MidnightOnMars/clawd-pico-case/stl/aw1/README.md

# Atomic Wedgie base v1 (RP2040-Plus with a battery)

**Old test. Don't print. For an Atomic Wedgie use [`stl/atomic-wedgie/`](../atomic-wedgie/README.md).**

`base-floor-down.stl`, red PETG. Battery plug slot, BOOT pin hole, and a hole
for a RESET button: print one more `stl/current/button.stl` in red and drop it
in from inside before the board. Lid, joystick and buttons from `stl/current/`.
