MidnightOnMars/clawd-pico-case/stl/aw2/README.md

# Atomic Wedgie base v2 (RP2040-Plus with a battery)

**Old test. Don't print. For an Atomic Wedgie use [`stl/atomic-wedgie/`](../atomic-wedgie/README.md).**

Same files as `stl/atomic-wedgie/` (red base, black RESET plunger). The
plunger is not a front button; "buttons" means `stl/current/button.stl`.
