MidnightOnMars/clawd-pico-case/stl/resin-v1/full-set.stl

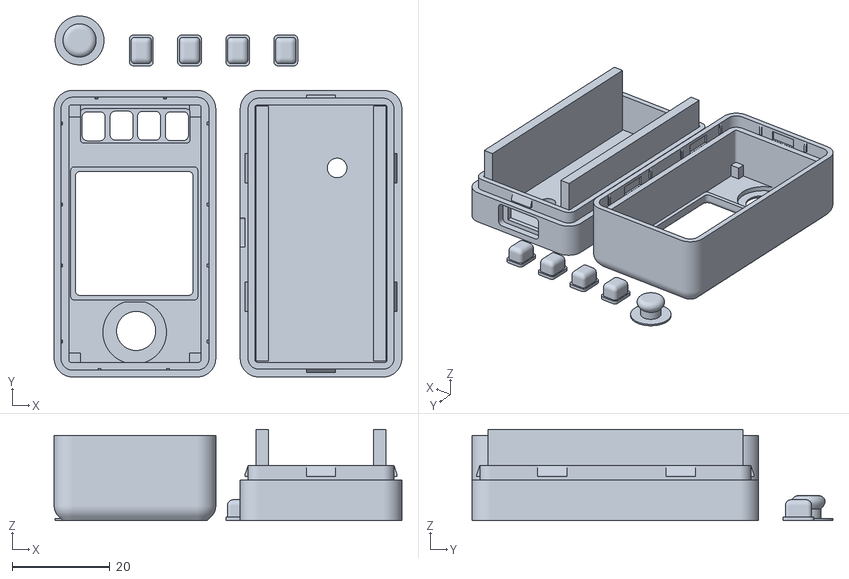
[picture p1: CAD file, 2026-10-23]
stl/resin-v1/full-set.stl
71.1 x 73.8 x 18.7
