MidnightOnMars/clawd-pico-case/stl/atomic-wedgie/aw-reset-plunger.stl

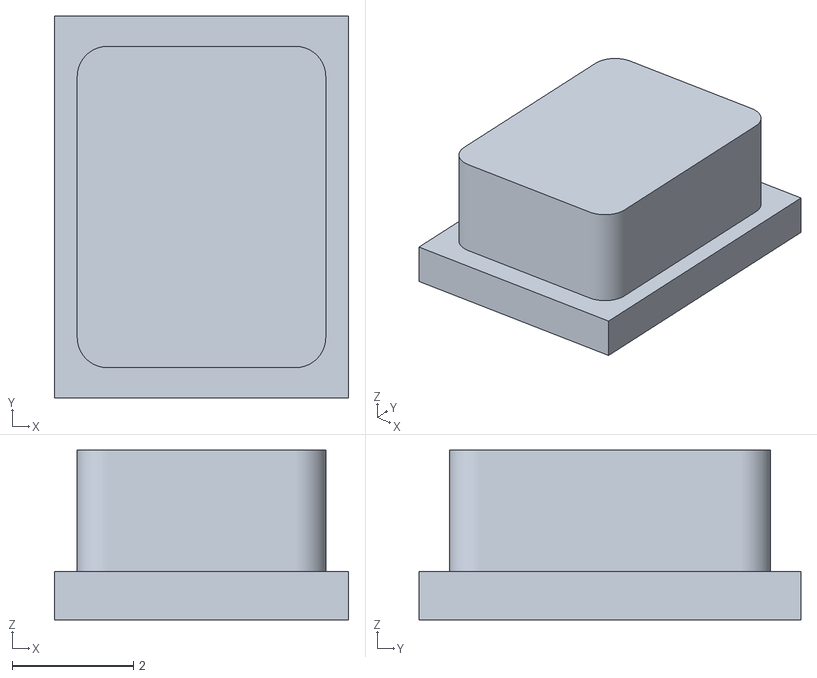
[picture p2: CAD file, 2026-10-13]
stl/atomic-wedgie/aw-reset-plunger.stl
4.85 x 6.30 x 2.80
