MidnightOnMars/clawd-pico-case/stl/resin-v1/joystick-j24-a.stl

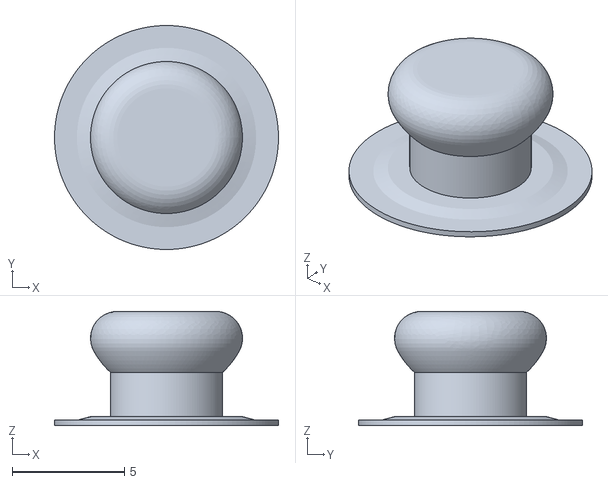
[picture p3: CAD file, 2026-11-12]
stl/resin-v1/joystick-j24-a.stl
10.0 x 10.00 x 5.10
