MidnightOnMars/clawd-pico-case/stl/resin-v1/button.stl

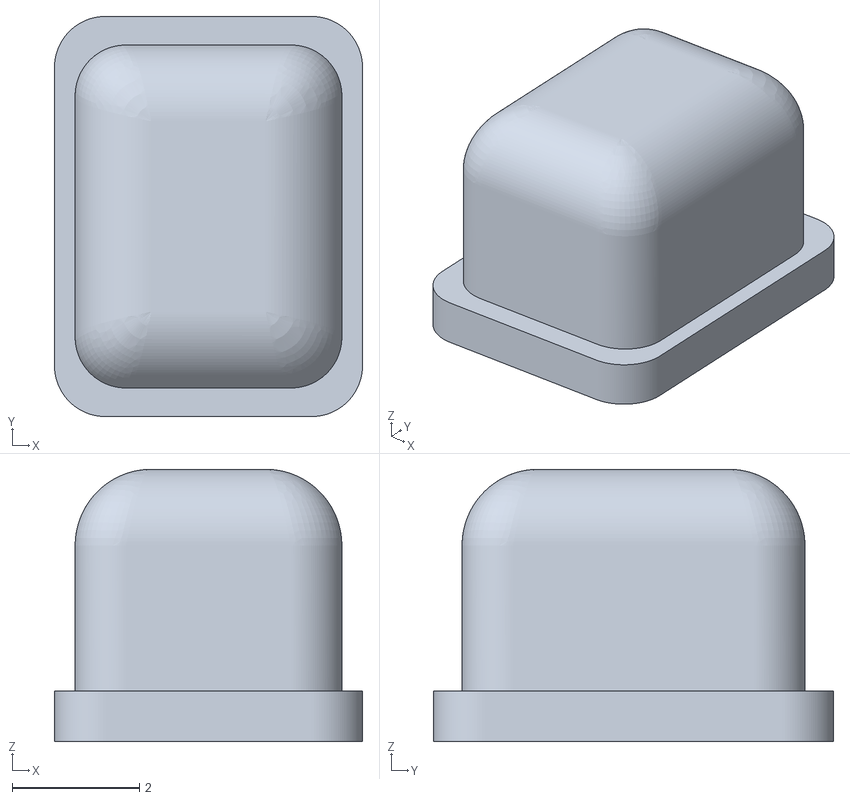
[picture p4: CAD file, 2026-10-23]
stl/resin-v1/button.stl
4.85 x 6.30 x 4.29
