MidnightOnMars/clawd-pico-case/stl/resin-v1/lid.stl

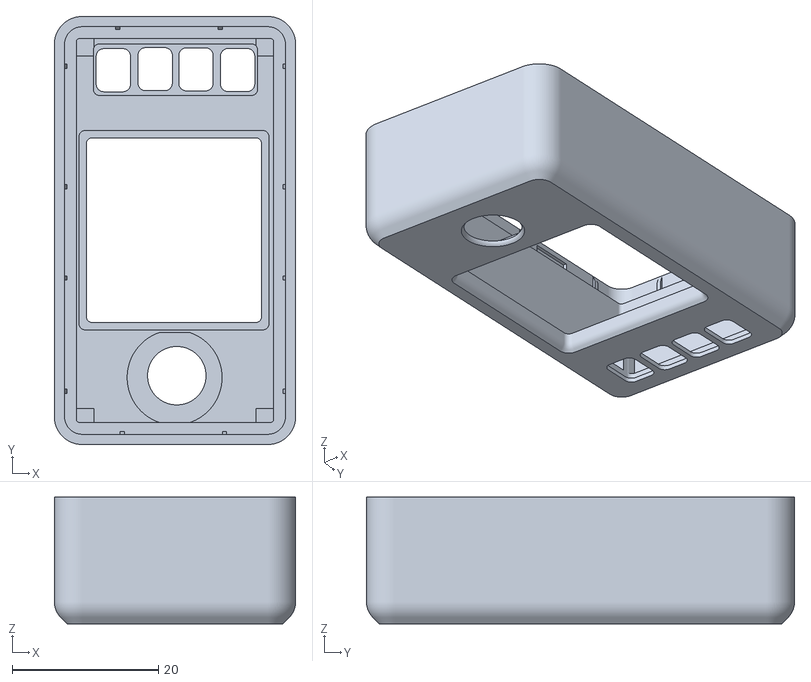
[picture p5: CAD file, 2026-10-23]
stl/resin-v1/lid.stl
33.0 x 58.6 x 17.4
