MidnightOnMars/clawd-pico-case/stl/resin-v1/base.stl

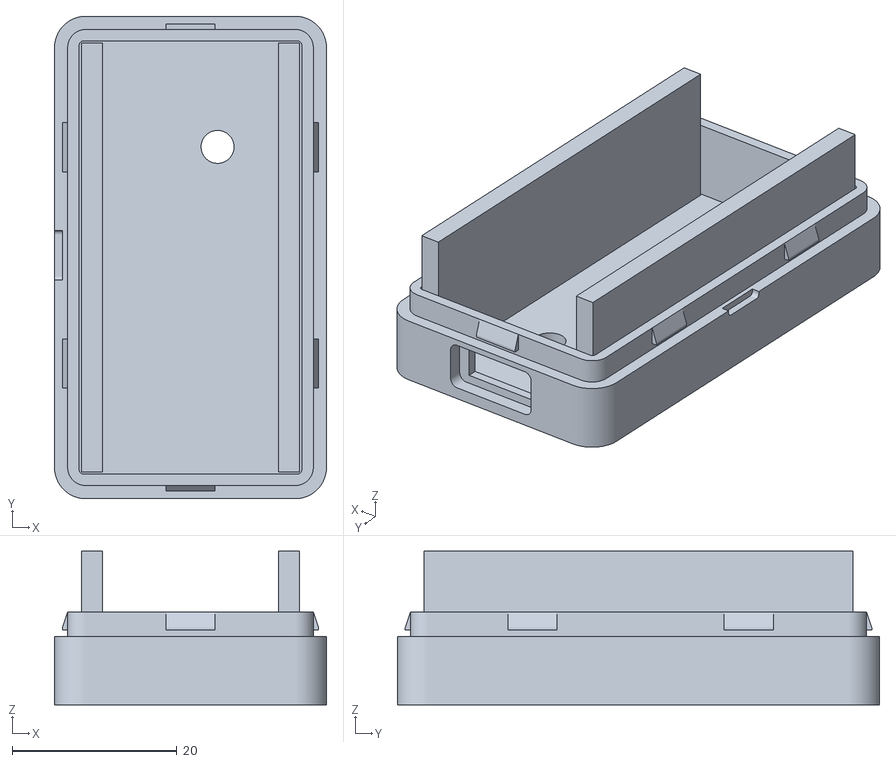
[picture p6: CAD file, 2026-10-23]
stl/resin-v1/base.stl
33.0 x 58.6 x 18.7
