MidnightOnMars/clawd-pico-case/(list of files, cad)

Other CAD files:
stl/resin-v1/joystick.stl
