MidnightOnMars/clawd-pico-case/prints/2026-11-12-resin-v1-first-article.md

# resin-v1 first article (planned, not printed yet)

First print of the resin variant, on a Formlabs Form Studio 1. It is a fit test:
nothing in `stl/resin-v1/` has been printed before. Print sheet and first-fit steps:
[`stl/resin-v1/README.md`](../stl/resin-v1/README.md).

| Print | Resin | File | SHA256 | Copies |
|---|---|---|---|---|
| 1 | Alpha Clear Resin | `stl/resin-v1/lid.stl` | `320b1b5c...` | 2 |
| 1 | Alpha Clear Resin | `stl/resin-v1/base.stl` | `6340c52a...` | 2 |
| 2 | Tough 2000 Resin V2 | `stl/resin-v1/joystick-j24-a.stl` (J24-A) | `2bc4d60b...` | 3: 100 %, 98.5 %, 97 % |
| 2 | Tough 2000 Resin V2 | `stl/resin-v1/joystick.stl` (J24-B) | `b9aef37b...` | 3: 100 %, 98.5 %, 97 % |
| 2 | Tough 2000 Resin V2 | `stl/resin-v1/button.stl` | `c5f2f4a3...` | 4 |
| 3 | Flexible 80A Resin V2 | `stl/resin-v1/button.stl` | `c5f2f4a3...` | 6 |

This is the print sheet's full list, the ideal. If time is tight the short list is
printed instead: one lid, one base, both joystick caps at 100 %, four rubber buttons.

Board for the fit test: a pink USB-C RP2040 Pico clone with soldered headers
([Amazon B0GQRMVT4P](https://www.amazon.com/dp/B0GQRMVT4P)). Its listing photo shows
the same layout as the PINK board in `MEASUREMENTS.md`: one button beside the USB-C
socket and the `Pico (c) 2022` silkscreen. It has not been measured against the PINK
rows.

Layer height: material default. Orientation and supports: the operator's choice,
except that the joystick caps must not sit flange down directly on the build platform
(print sheet, Print setup). Record what was used below.

## Results

Fill in after the fit test. A planned test is not evidence of a successful print.

- List printed (full or short) and any extras added:
- Date printed, printer, PreForm version:
- Orientation and supports used for each part:
- Post-cure used for the clear parts:
- Empty lid on empty base, as printed: seated? clicked? how much force?
- Crush ribs: left as printed, or eased by how much:
- Catches: latched as printed, or trimmed:
- Clear skirt at the six pockets after closing and after opening:
- Opening at the pry slot:
- With the boards in: seated? pads or end walls eased?
- USB cable:
- Joystick: which cap (A or B, which scale) grips the stick; any double click or clunk:
- Buttons: rubber caps stay in? feel? rigid spares used?
- Closed case height (model 25.64 mm; Austin's PETG case measured 25.76):
- Photos:
