MidnightOnMars/clawd-pico-case/assembly/ASSEMBLY.md

# Assembly

Photos in order. Draft. This becomes a one-page guide later.

## What you need

- Screen board (Waveshare Pico-LCD-1.3)
- Pico (the red USB-C RP2040 board)
- Trust M chip board
- 4-wire cable (white, yellow, black, red) with a small plug: [the ones we use (Amazon)](https://www.amazon.com/dp/B0F6TYG426)
- Case: white lid, black base, joystick cap, 4 buttons (1 green, 2 gray, 1 red)
- Wire cutters and strippers, electrical tape, a stiff breadboard jumper wire, tweezers
- A computer with Chrome, and a USB-C cable

## 1. Cable and tools

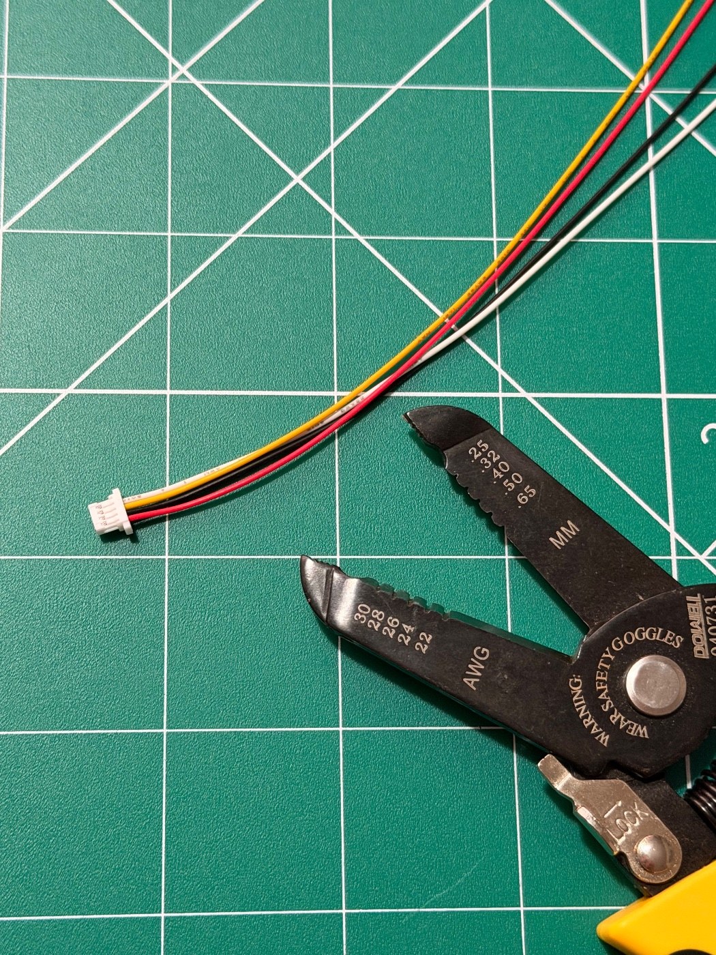
[picture p7: assembly/photos/01-cable-and-strippers.jpg]
Cable and strippers


Cable and strippers

## 2. Cut and strip the wires

Keep one plug. Cut the wires about 2 in (5 cm) from it. Strip off as much as a header socket is deep, about 5 mm (between 1/8 and 1/4 in), so the bare wire goes all the way down.

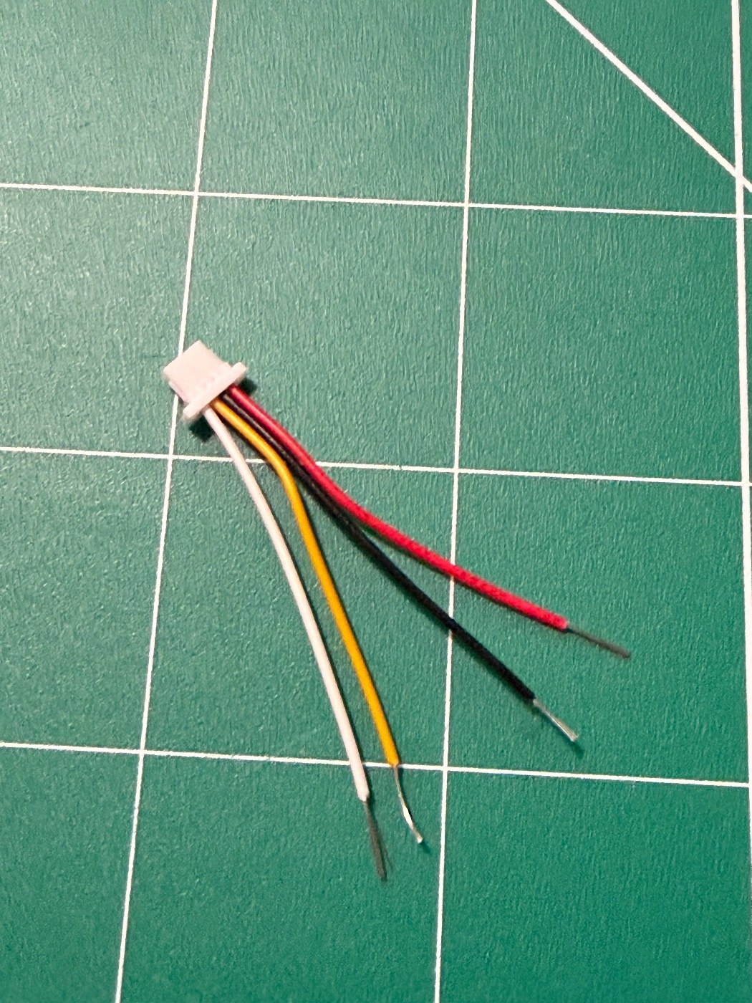
[picture p8: assembly/photos/03-cut-and-stripped-a.jpg]
Cut and stripped

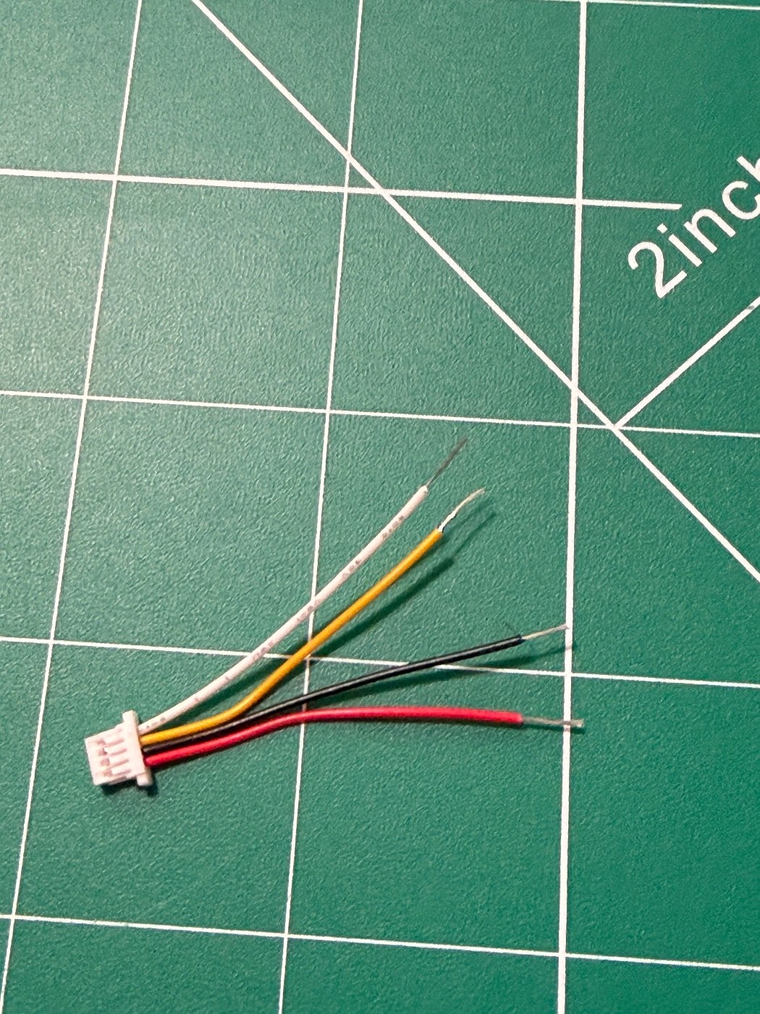
[picture p9: assembly/photos/03-cut-and-stripped-b.jpg]
Cut and stripped, other view


## 3. Lay out the screen board and the wiring guide

Take out the screen board. Turn it face down, sockets up, USB mark at the top.

Each wire pushes into a socket. No solder. Count sockets from the USB end.

| Wire | Signal | Socket |
|---|---|---|
| White | GND | 3rd on the USB-side row (pin 38) |
| Yellow | 3.3 V | 5th on that row (pin 36) |
| Black | SDA | 6th on the other row (pin 6, GP4) |
| Red | SCL | 7th on the other row (pin 7, GP5) |

<!-- TODO: redraw the wiring guide as a clean diagram for the one-pager -->

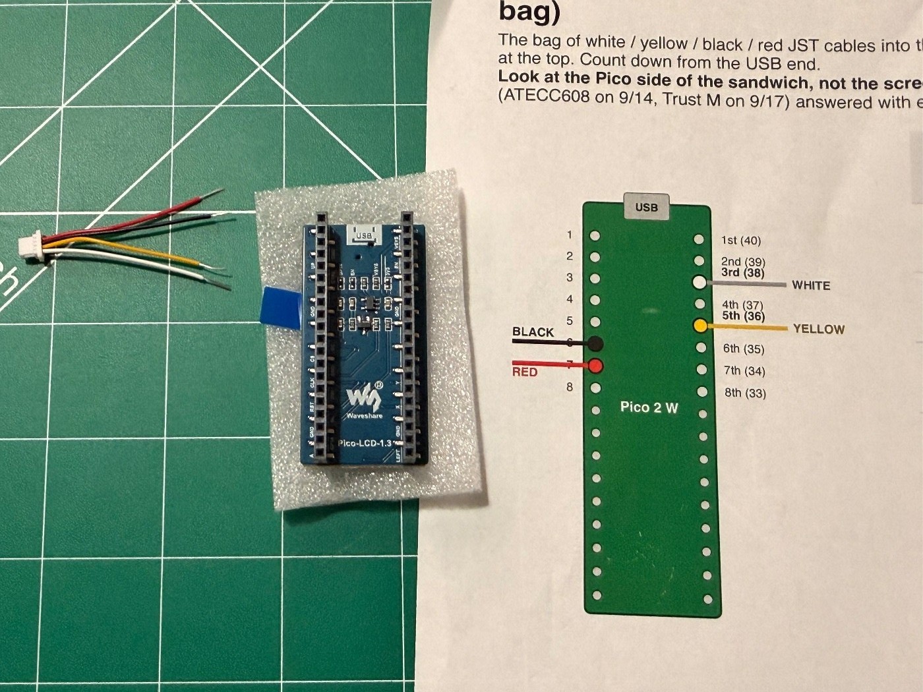
[picture p10: assembly/photos/04-board-and-guide.jpg]
Board face down with wiring guide


## 4. Push in white and yellow

Twist the strands at each wire tip tight, so each tip acts like one solid wire.

Push white into socket 3 (GND) and yellow into socket 5 (3V3) on the USB-side row. Do both together.

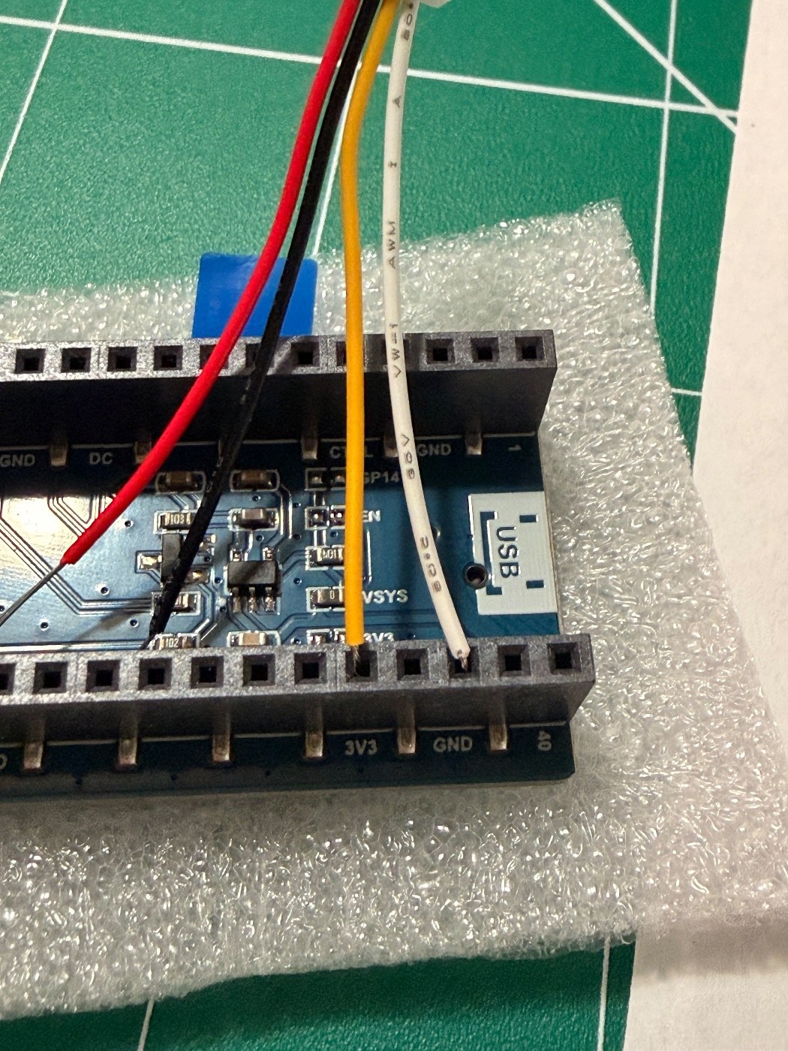
[picture p11: assembly/photos/05-white-yellow-in-header.jpg]
White and yellow in the header


## 5. Tape over the wires

Put a small piece of electrical tape over the sockets, right on top of the wires, to hold them in.

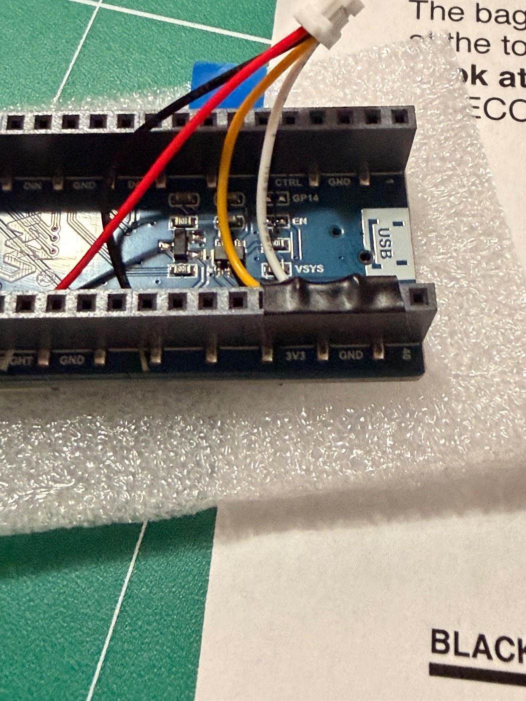
[picture p12: assembly/photos/06-tape-over-wires.jpg]
Tape over white and yellow


## 6. Poke the holes open

Push a stiff breadboard jumper wire through the tape into each covered socket. This opens the holes so the Pico pins fit later. The tape still holds the wires.

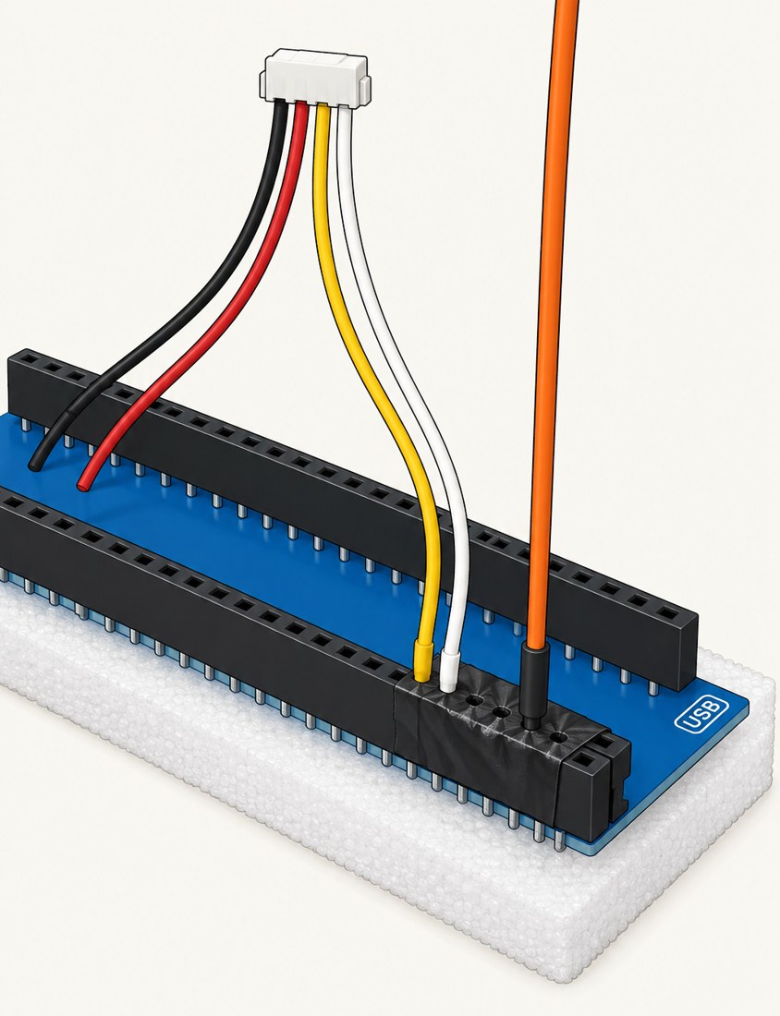
[picture p13: assembly/photos/07-poke-holes-drawing.jpg]
Poke the holes through the tape (drawing)

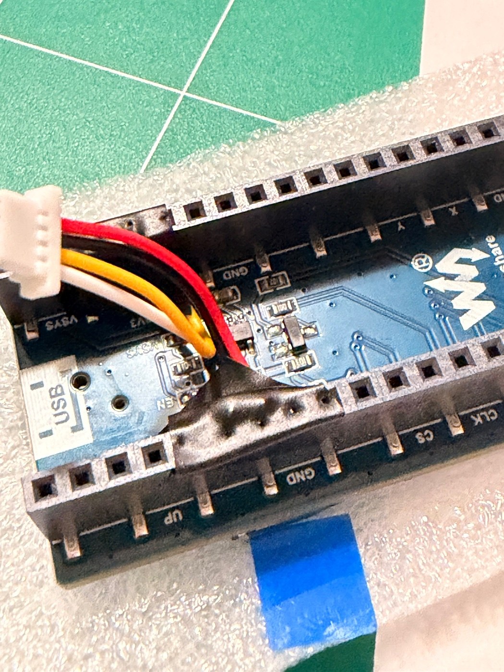
[picture p14: assembly/photos/08-black-red-taped.jpg]
Holes poked through the tape

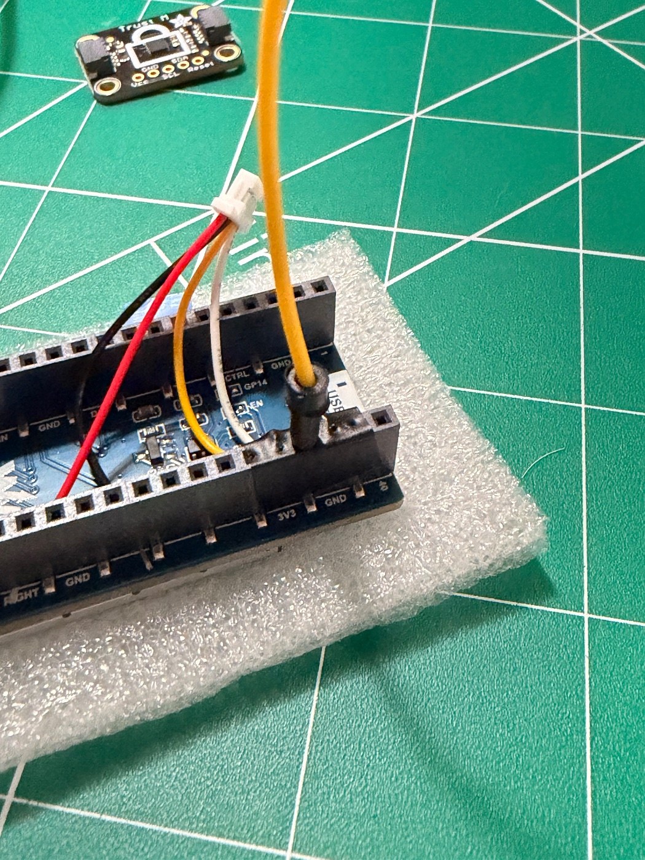
[picture p15: assembly/photos/07-poke-holes-through-tape.jpg]
Poking holes through the tape


## 7. Same on the other row: black and red

Push black into socket 6 and red into socket 7. Tape over them. Poke the holes open with the jumper wire.

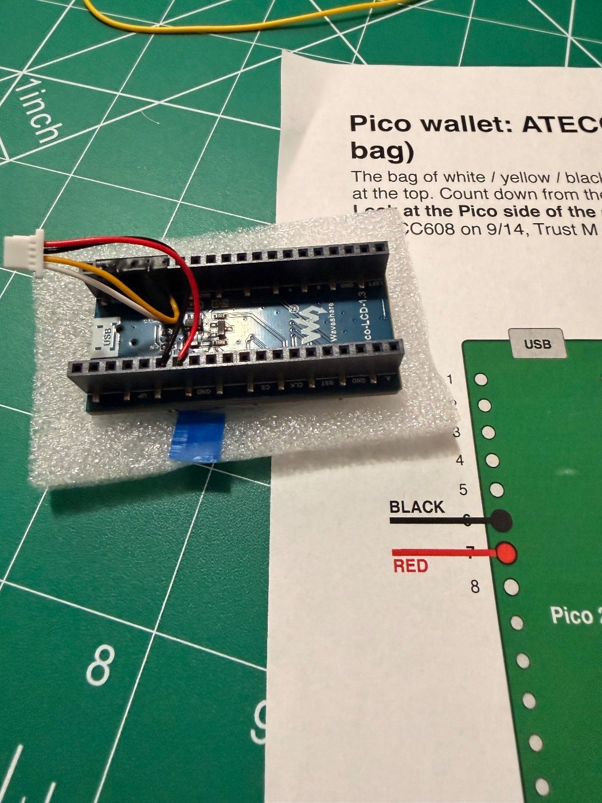
[picture p16: assembly/photos/08-black-red-guide.jpg]
Black and red, with guide

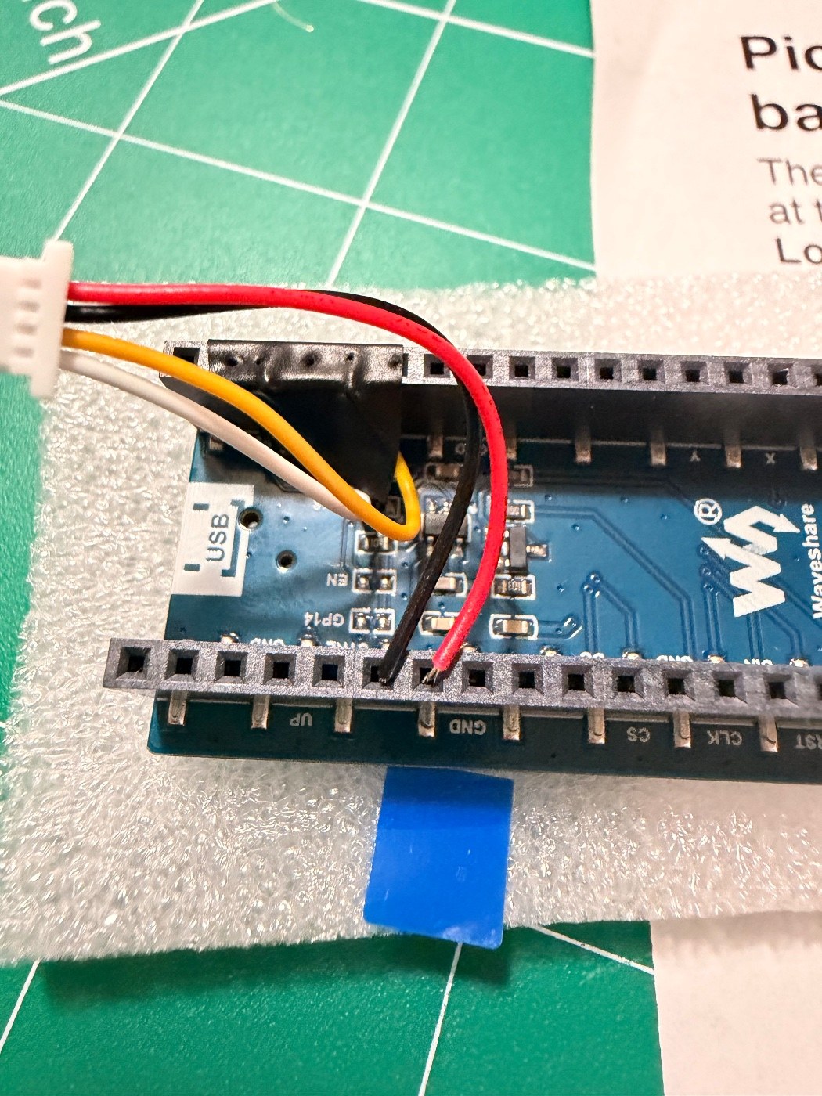
[picture p17: assembly/photos/08-black-red-in-header.jpg]
Black and red in the header

Black and red taped

## 8. Header ready

All 4 wires in, taped, holes open. Ready for the Pico.

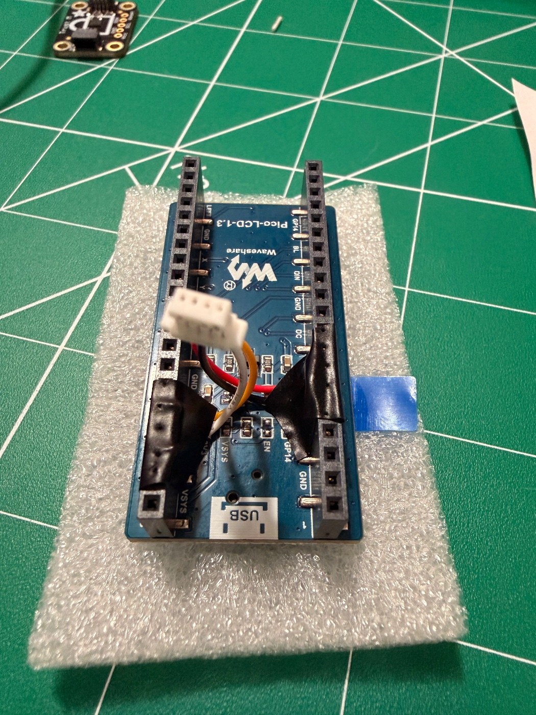
[picture p18: assembly/photos/09-header-ready.jpg]
Header ready for the Pico


## 9. How the plug fits the Trust M

Only 4 wires. Top to bottom in the photo: white, yellow, black, red.

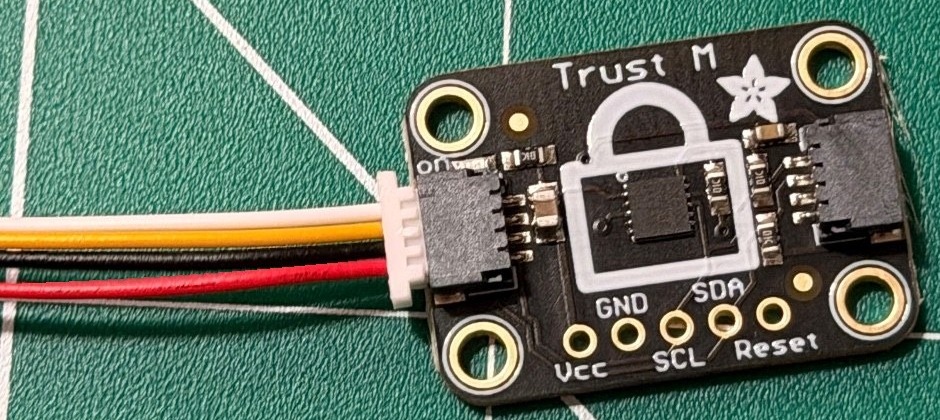
[picture p19: assembly/photos/02-trust-m-plug.jpg]
Cable plugged into Trust M


## 10. Plug in the chip

Plug the cable into the Trust M. It only fits one way.

Lay the Trust M face up on the back of the screen board, over the wires. The Pico goes on top of it next.

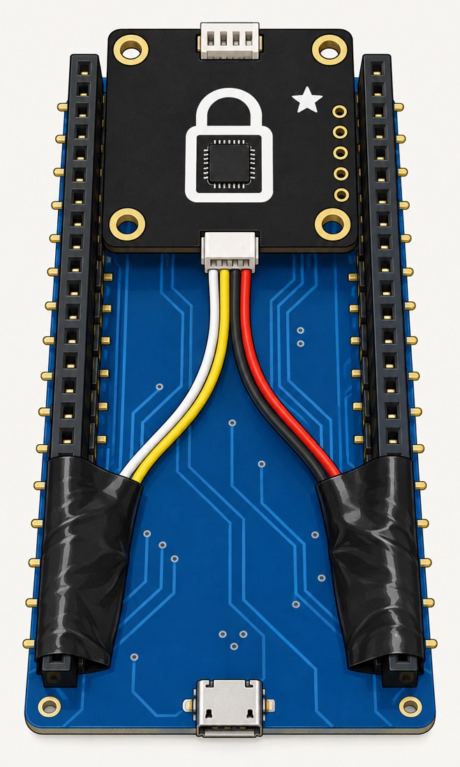
[picture p20: assembly/photos/10-chip-drawing.jpg]
Chip plugged in and laid down (drawing)

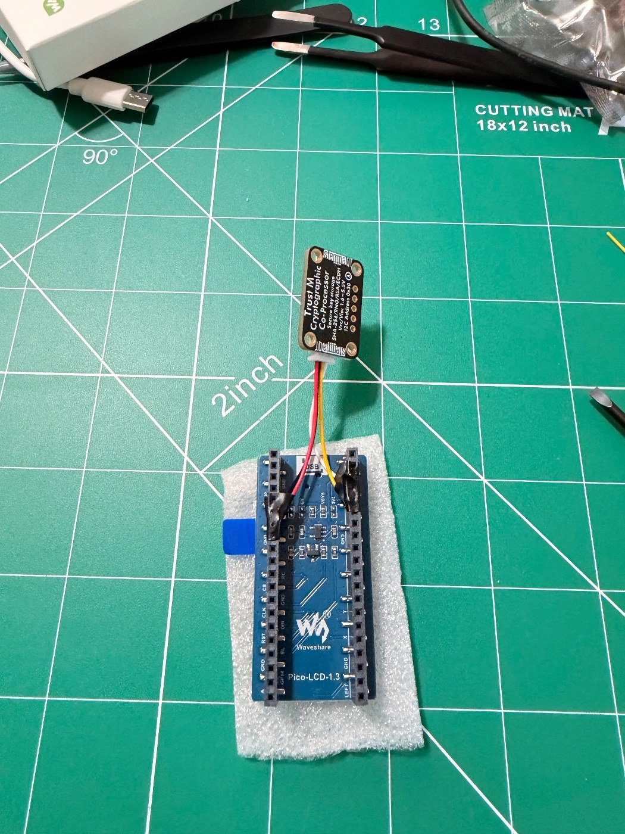
[picture p21: assembly/photos/10-chip-plugged.jpg]
Plugged in

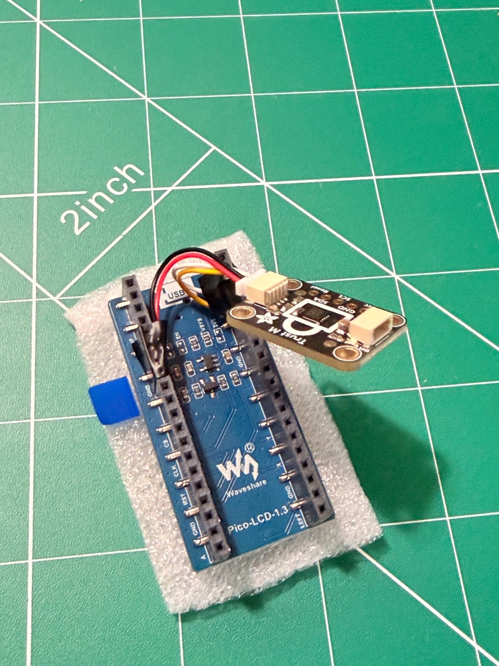
[picture p22: assembly/photos/10-chip-plugged-side.jpg]
Plugged in, from the side

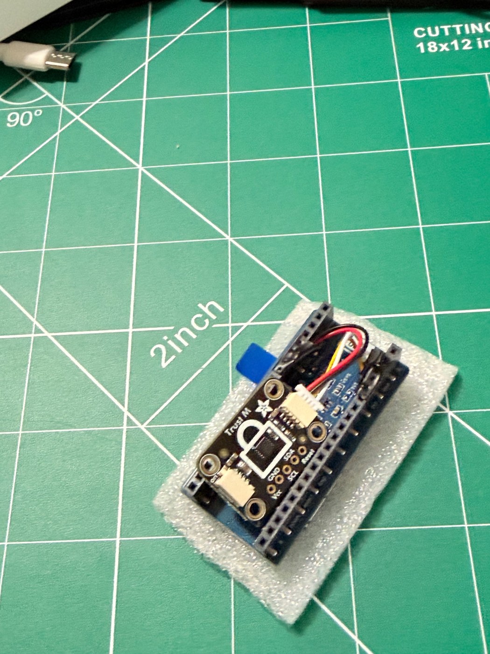
[picture p23: assembly/photos/10-chip-laid-down.jpg]
Laid down on the board

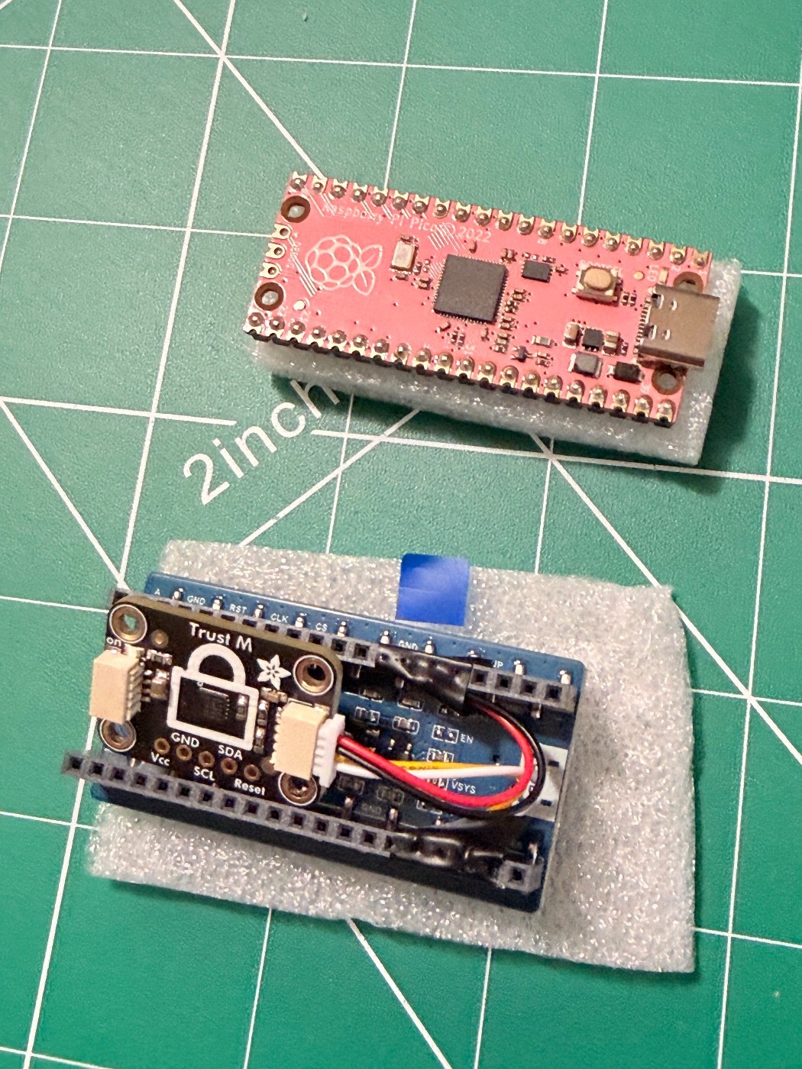
[picture p24: assembly/photos/10-ready-for-pico.jpg]
Ready for the Pico


## 11. Snap off extra board

Some Picos have a little extra board left on the end, away from the USB-C. Pinch it with pliers and snap it off. Otherwise it won't fit the case.

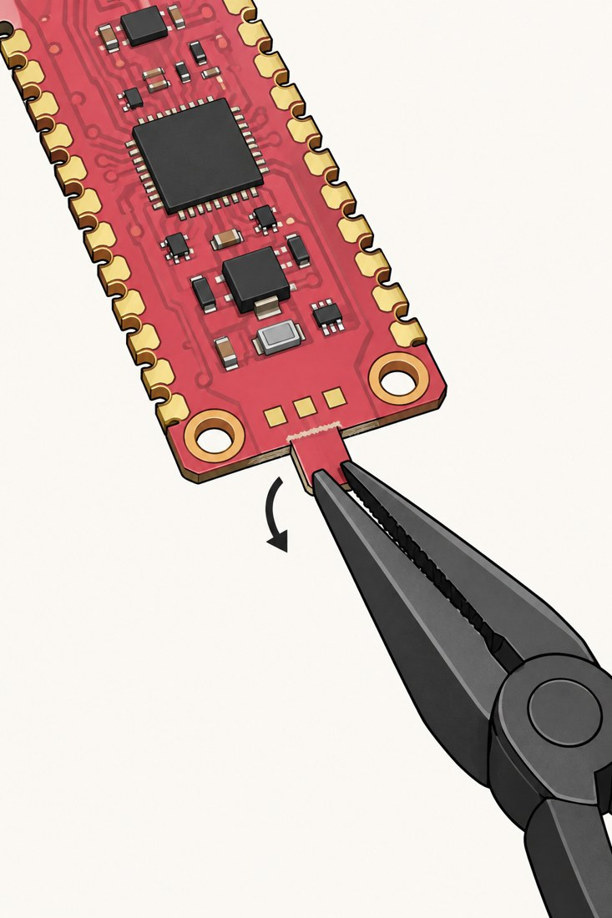
[picture p25: assembly/photos/11-snap-off-tab-drawing.jpg]
Snap off the extra board (drawing)

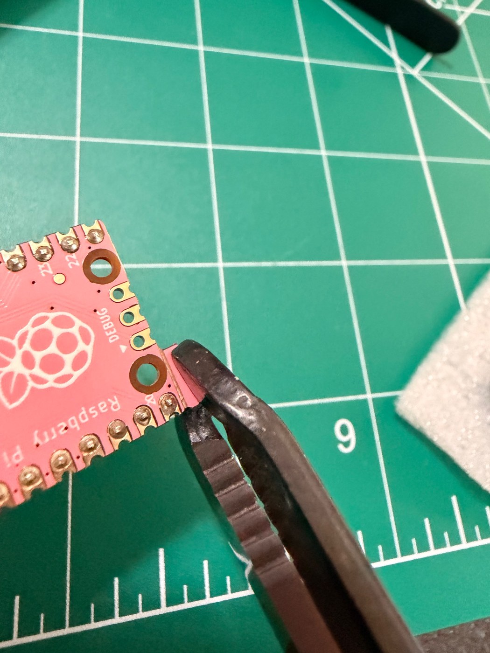
[picture p26: assembly/photos/11-snap-off-tab.jpg]
Pinch and snap

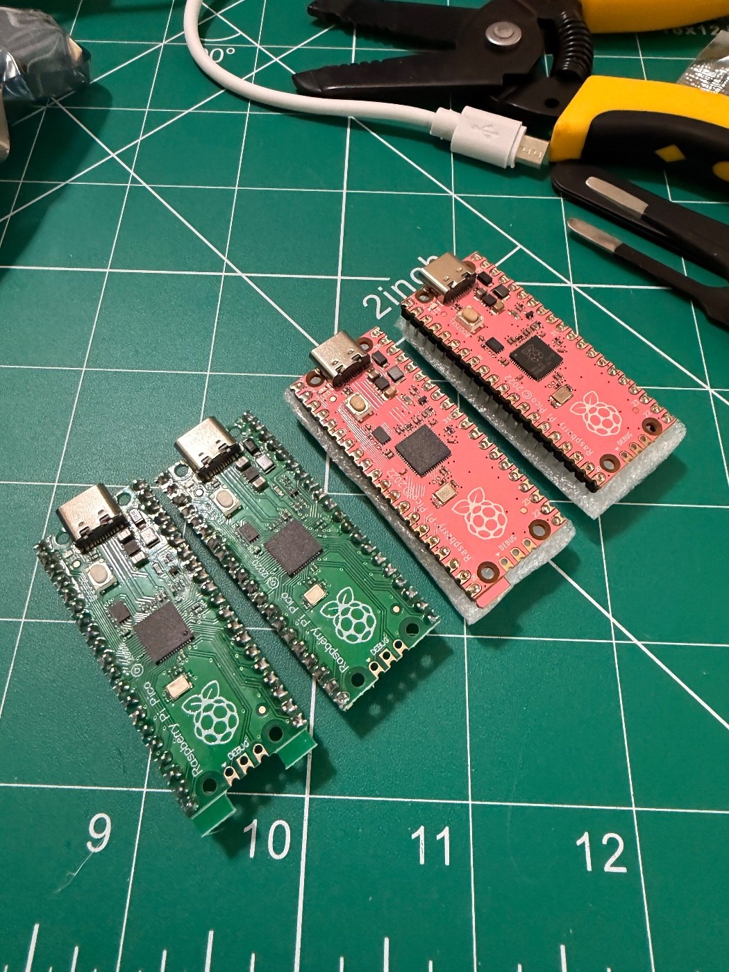
[picture p27: assembly/photos/11-picos-with-tabs.jpg]
Green Picos still have it, red ones are done


## 12. Stack the boards

Push the Pico into the sockets, USB-C at the same end as the screen board's USB mark. The Pico's chips and BOOTSEL button face out, away from the screen. Push straight, never at an angle. The Trust M ends up wedged between the two boards. Push the Pico all the way in so it's flush. No pins or wires sticking out, chip fully inside.

If anything sticks out, do it again. It won't fit the case.

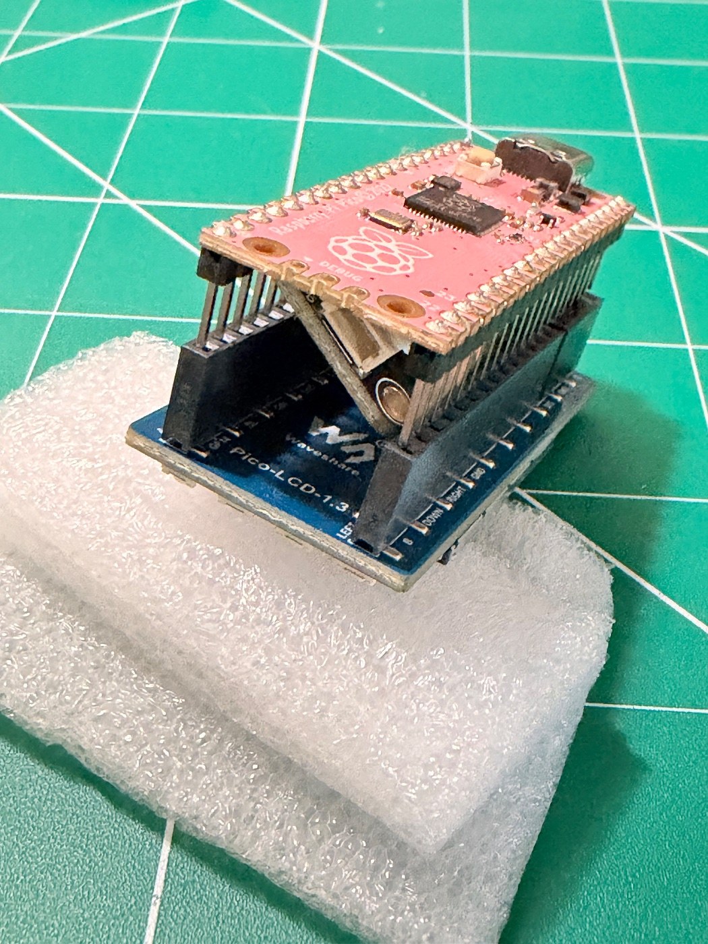
[picture p28: assembly/photos/11-pico-going-on.jpg]
Pico going on, chip wedged under it

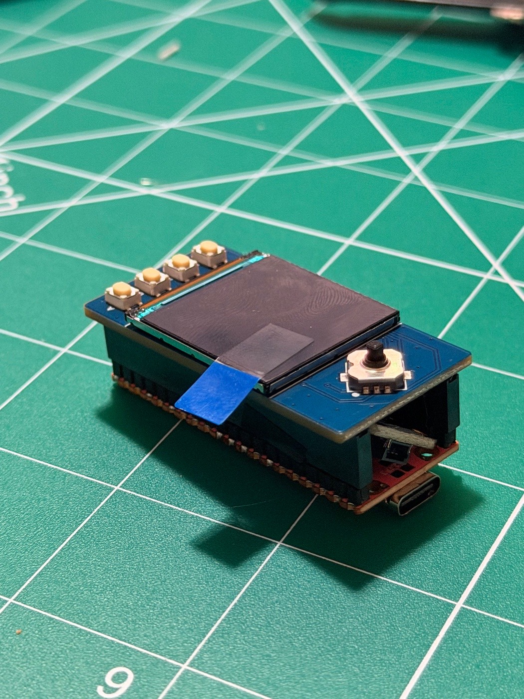
[picture p29: assembly/photos/10-stacked-top.jpg]
Stacked, from the top

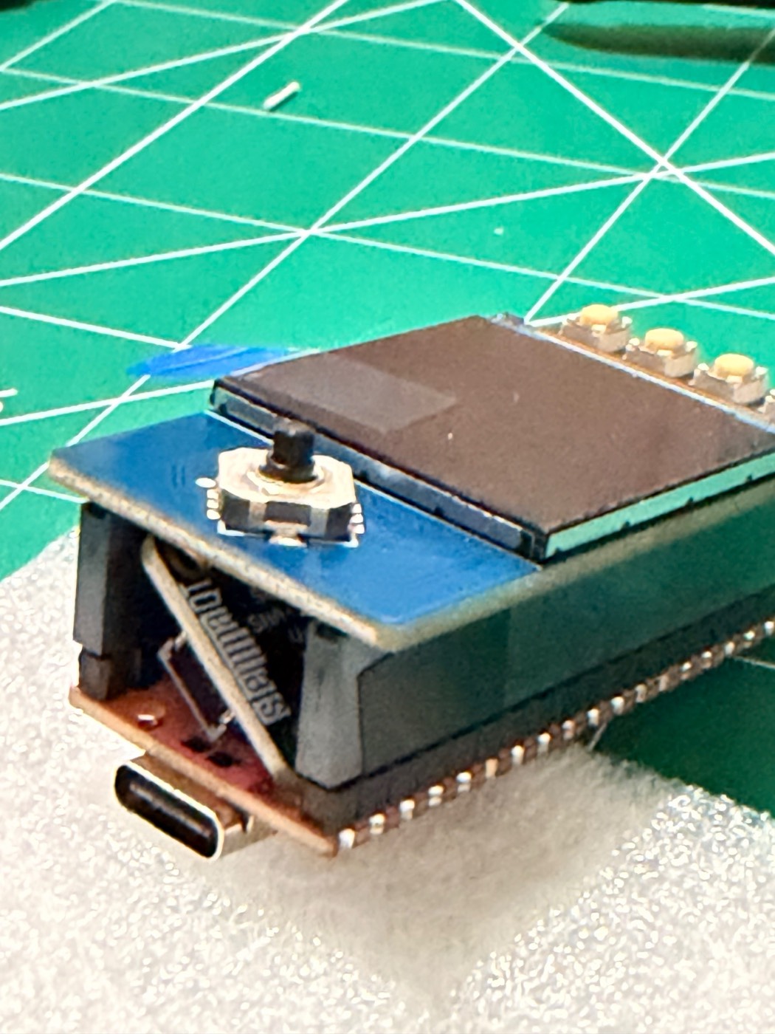
[picture p30: assembly/photos/10-chip-wedged.jpg]
Chip wedged in between

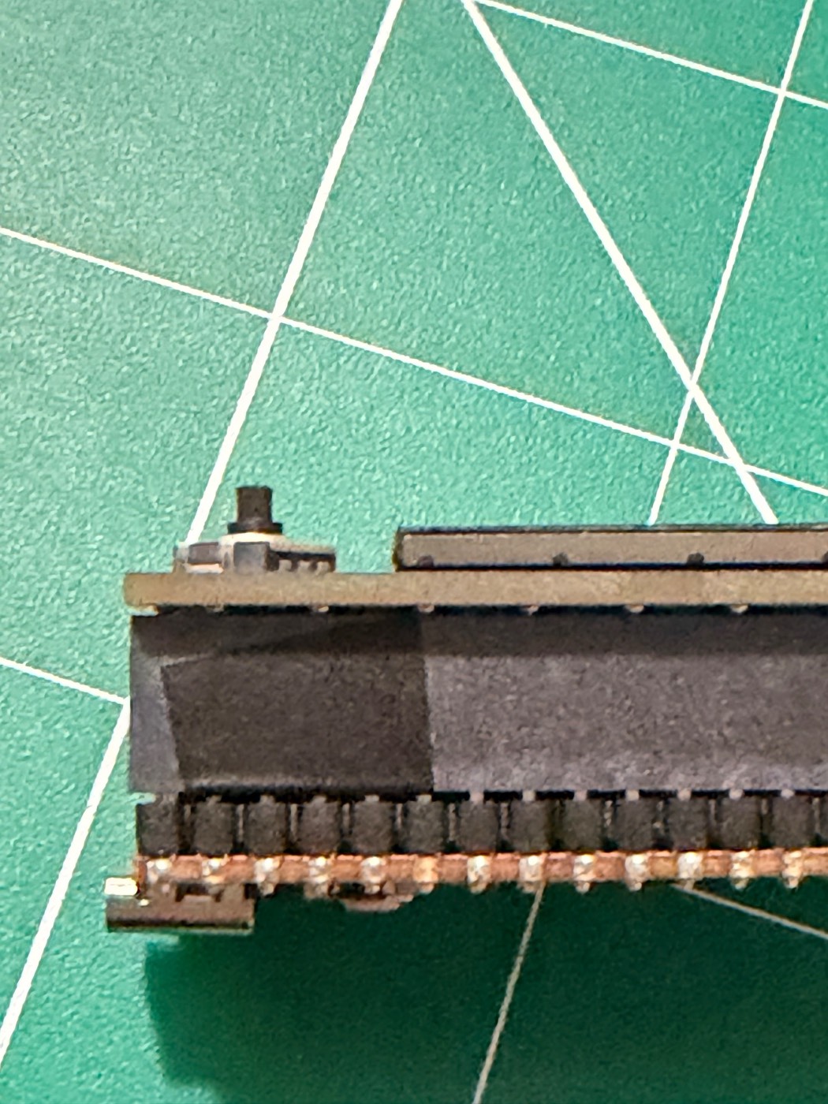
[picture p31: assembly/photos/10-headers-flush.jpg]
Headers flush

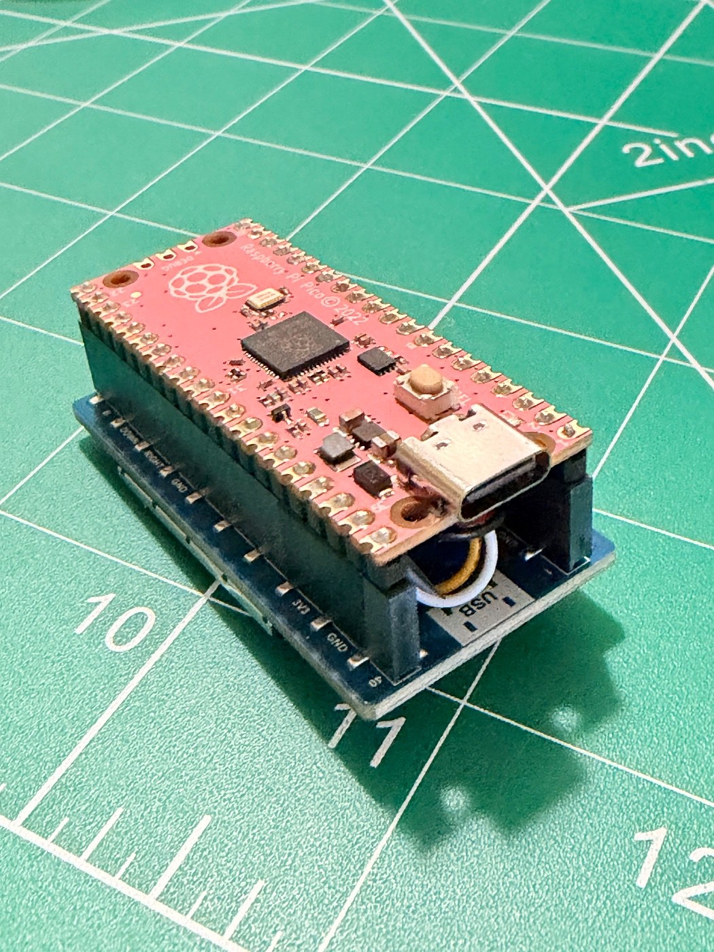
[picture p32: assembly/photos/11-stacked-usb.jpg]
Stacked, USB end


## 13. Test the boards

Hold the Pico's BOOTSEL button (tweezers help) and plug in the USB-C. Always hold it. Many Picos come with software installed and won't show up without BOOTSEL. Our pink Picos do: out of the box they flash a green light. Some come blank and work either way. Use a data cable, not a charge-only one. Go to wedgie.dev/test in Chrome and click Test it. Don't unplug while it runs.

First time on this computer? The test page has a one-time setup (a Mac profile, or one command on Linux) so Chrome stops asking about every new Pico.

Wait for the first 3 to go green: Board, Firmware, Chip. That means everything is connected. Unplug it. The other 3 (Shake, Buttons, Colors) come after the case is on.

Chip fails? A wire is in the wrong socket (step 3), a wire came out, or the Trust M touches a Pico pin. Take it apart and check.

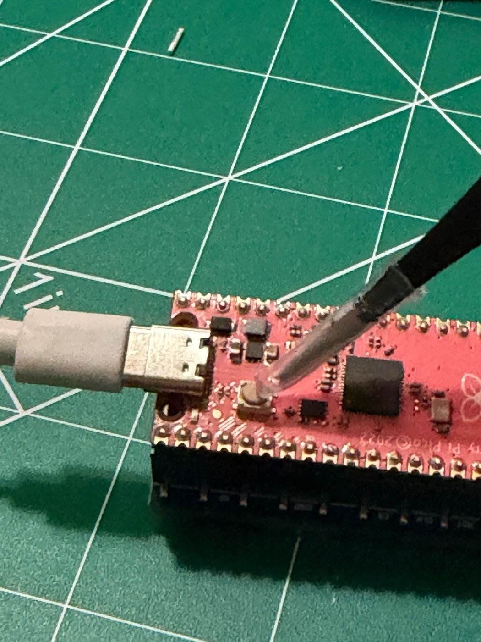
[picture p33: assembly/photos/11-bootsel.jpg]
Hold BOOTSEL, plug in

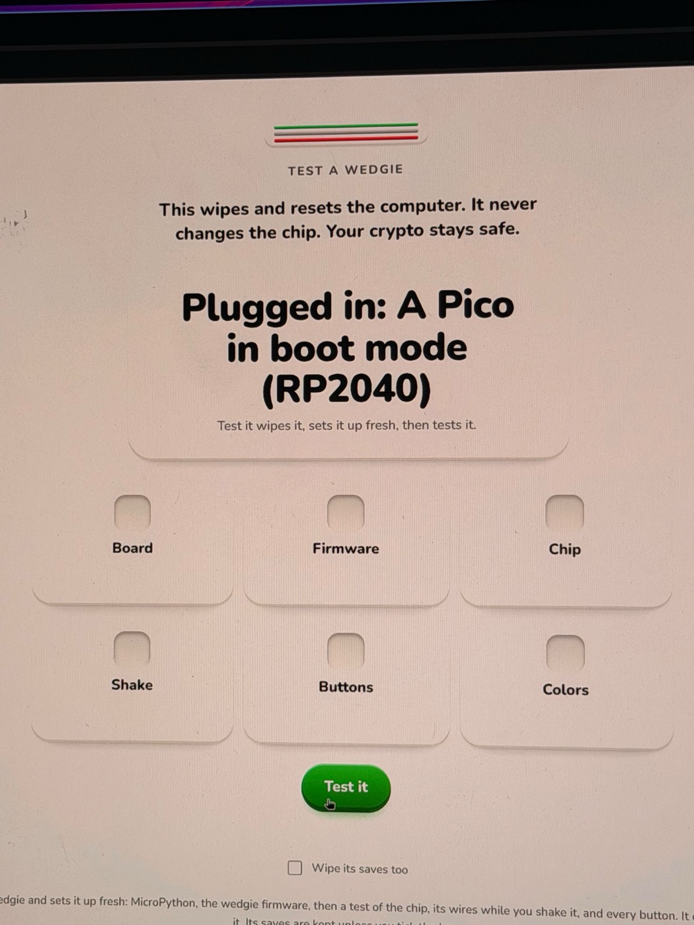
[picture p34: assembly/photos/11-test-page.jpg]
Test page

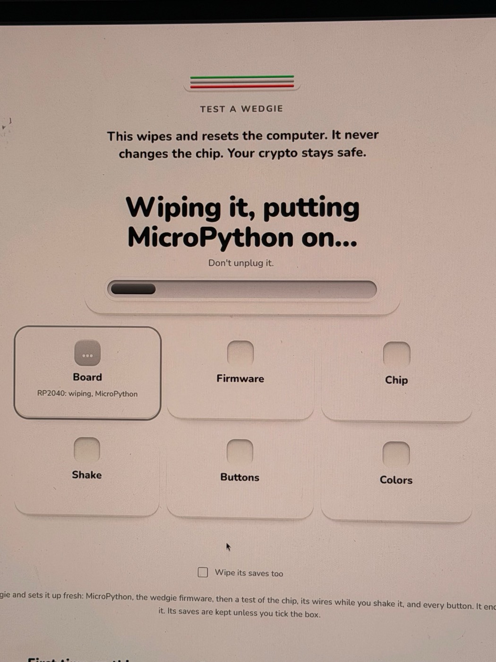
[picture p35: assembly/photos/11-test-wiping.jpg]
Wiping, putting MicroPython on

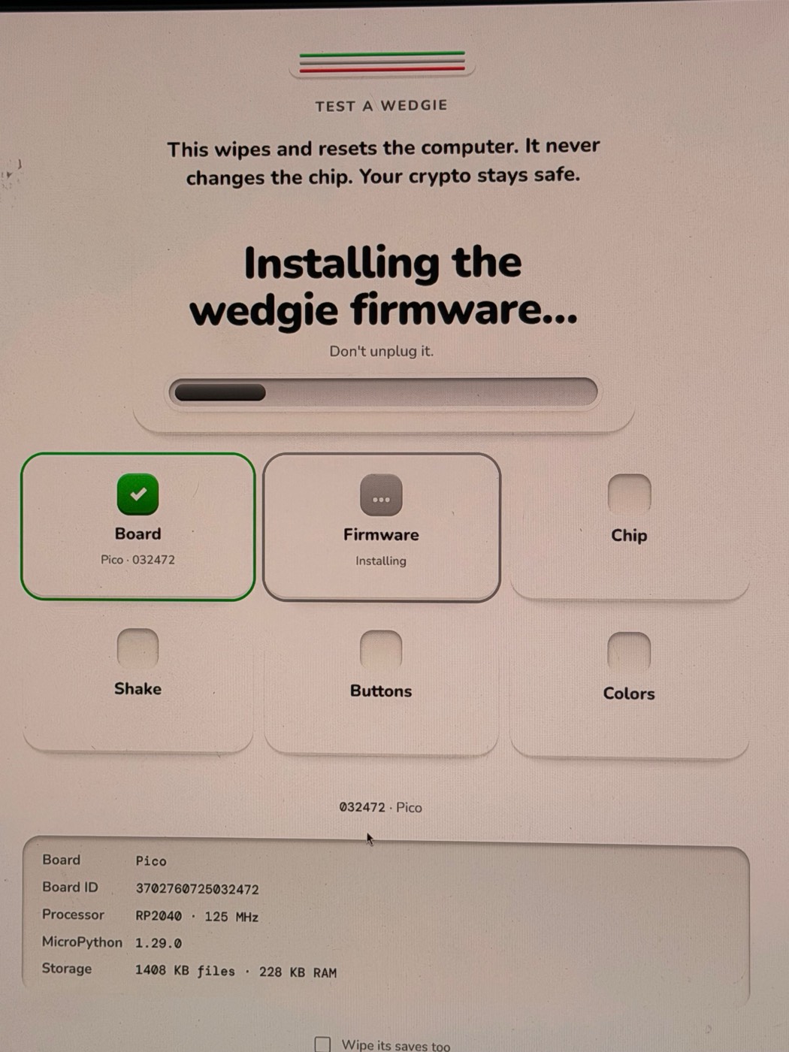
[picture p36: assembly/photos/11-test-firmware.jpg]
Installing the firmware


## 14. Pick the base

The base color says what's inside:

- Red: Pico W with a battery (the Atomic wedgie)
- Black: Trust M chip
- Gray: ATECC608 chip

This build is Trust M, so black.

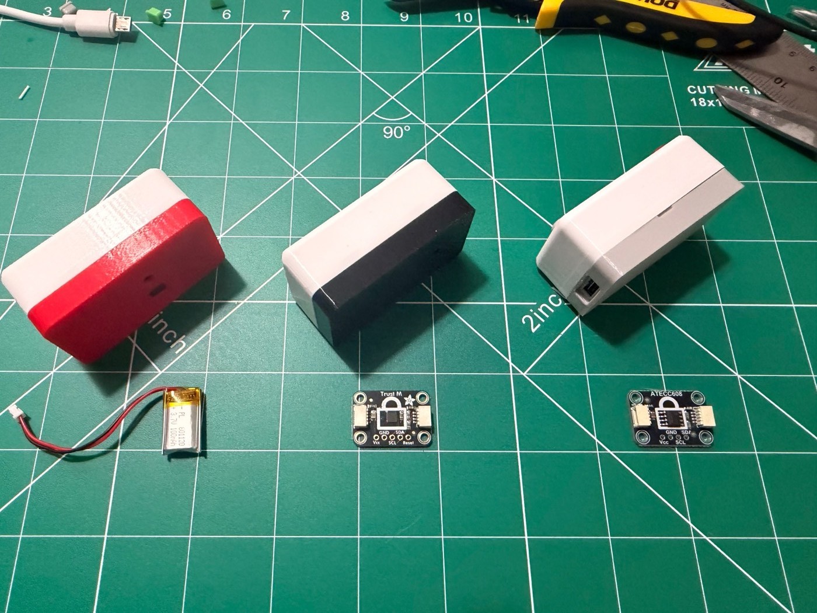
[picture p37: assembly/photos/13-bases.jpg]
The three bases


## 15. Check the USB-C fit

Set the stacked boards into the base, USB-C into the hole. The USB-C port must line up perfectly with the hole.

Not lined up? Push the Pico all the way into the screen board's sockets, and make sure the screen board sits flush on the base's supports.

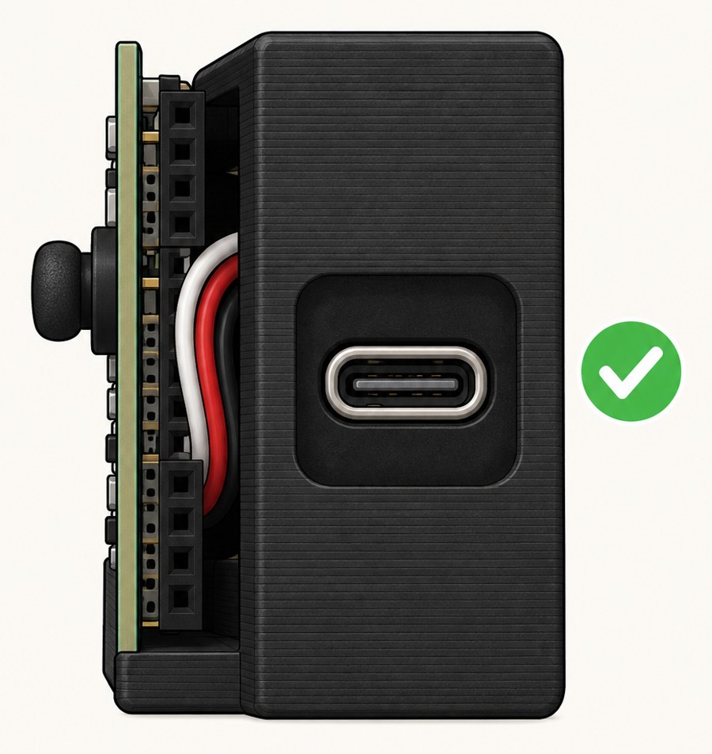
[picture p38: assembly/photos/15-usb-fit-drawing.jpg]
USB-C lined up with the hole (drawing)

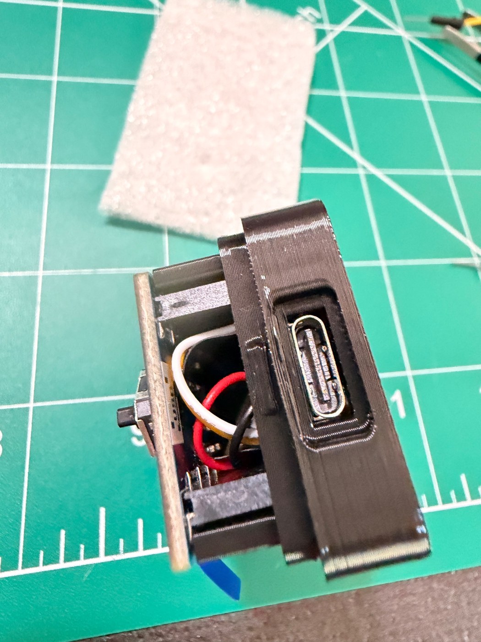
[picture p39: assembly/photos/15-usb-fit-check.jpg]
USB-C lined up with the hole


## 16. Peel the screen protector

Pull the blue tab off the screen.

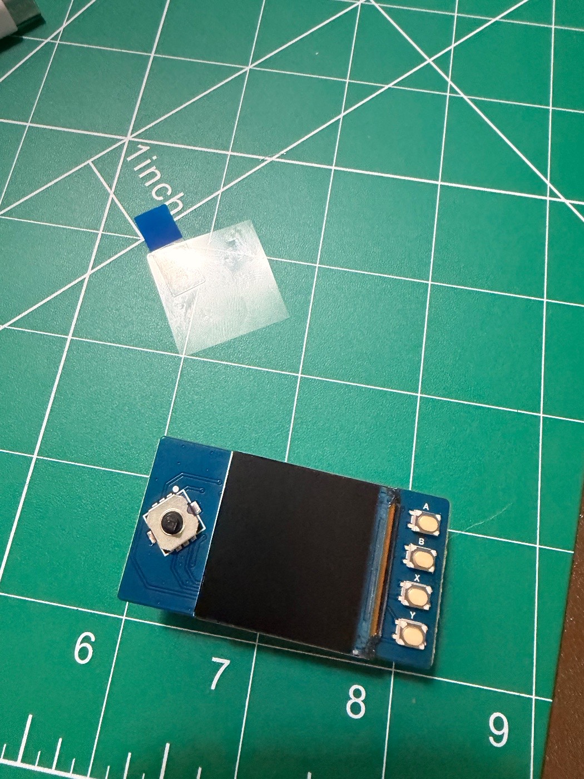
[picture p40: assembly/photos/13-screen-protector.jpg]
Screen protector off


## 17. Case parts

White lid, black base, joystick cap, 2 gray buttons, 1 green, 1 red.

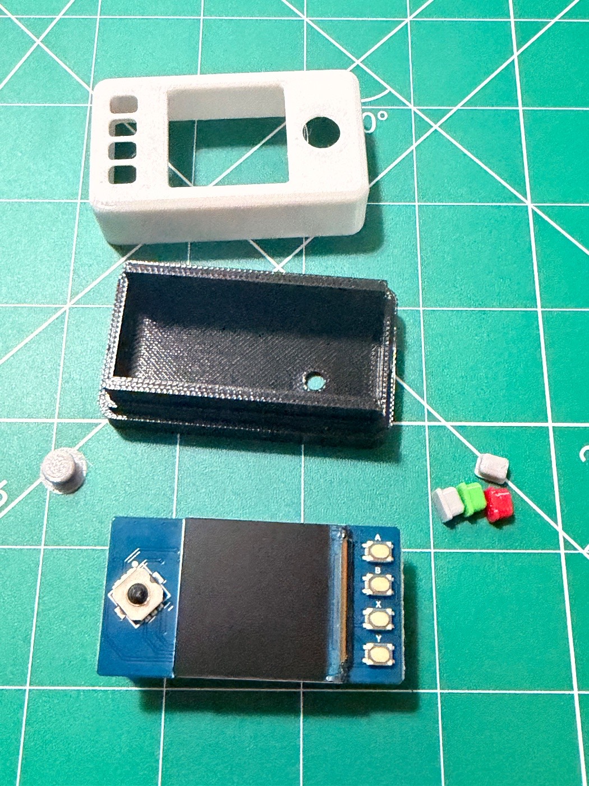
[picture p41: assembly/photos/14-case-parts.jpg]
Case parts


## 18. Joystick cap

Line up the square hole with the joystick and press hard until it snaps. It takes more force than you'd think.

Check: it stays on upside down, and it clicks up, down, left, right and in. The cap sits flat with a small gap under its rim. The gap is on purpose, so it can tilt.

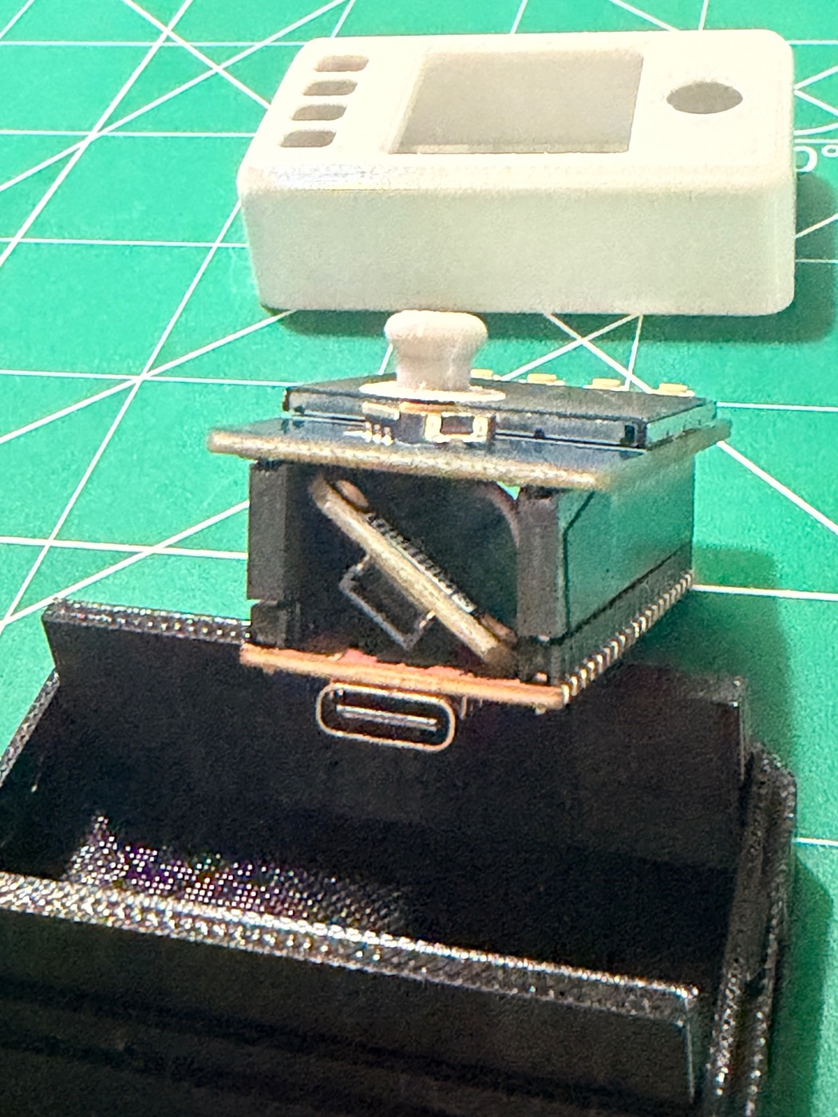
[picture p42: assembly/photos/15-joystick-side.jpg]
Joystick cap, side

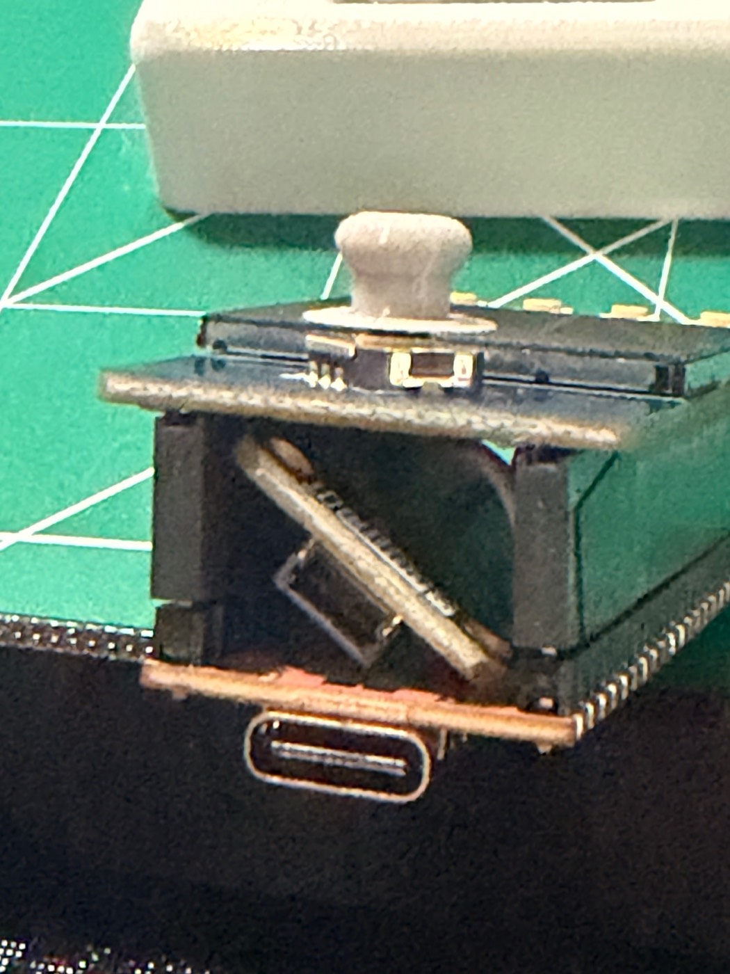
[picture p43: assembly/photos/15-joystick-gap.jpg]
The gap under the rim

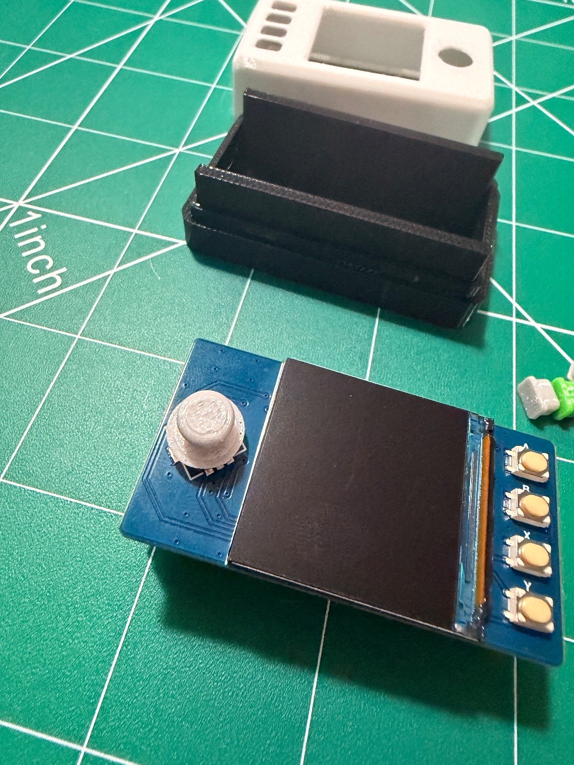
[picture p44: assembly/photos/15-joystick-on.jpg]
Joystick cap on


## 19. Buttons into the lid

Lay the lid face down at the edge of the mat, so the buttons can hang out the front. Drop the buttons in with tweezers: green, gray, gray, red. Green sits over the screen board's A button, red over Y.

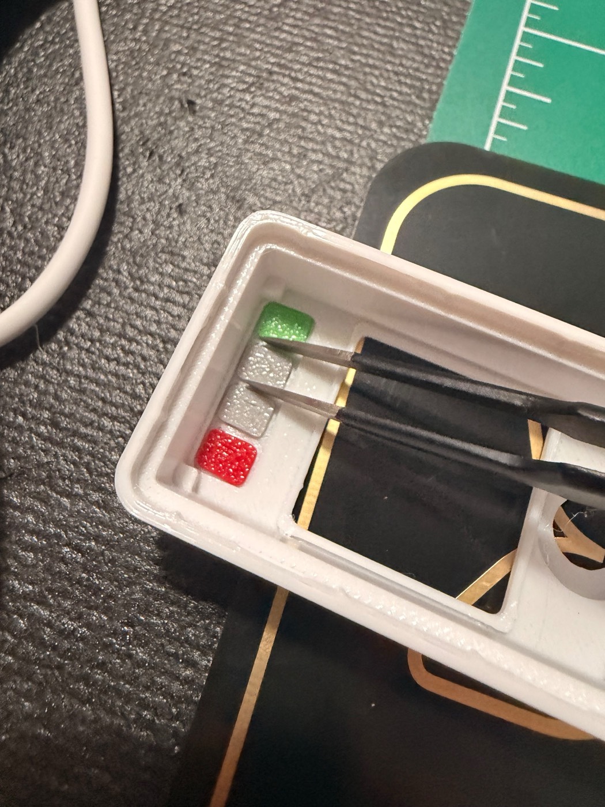
[picture p45: assembly/photos/16-buttons-tweezers.jpg]
Placing buttons with tweezers

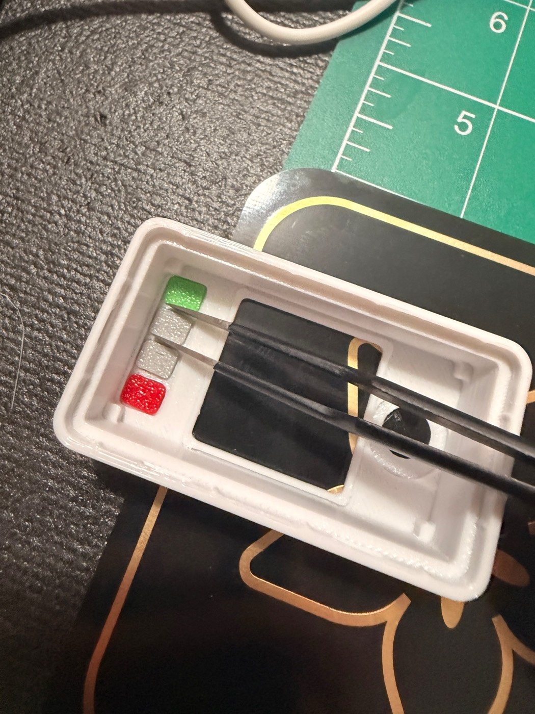
[picture p46: assembly/photos/16-buttons-placed.jpg]
Buttons placed

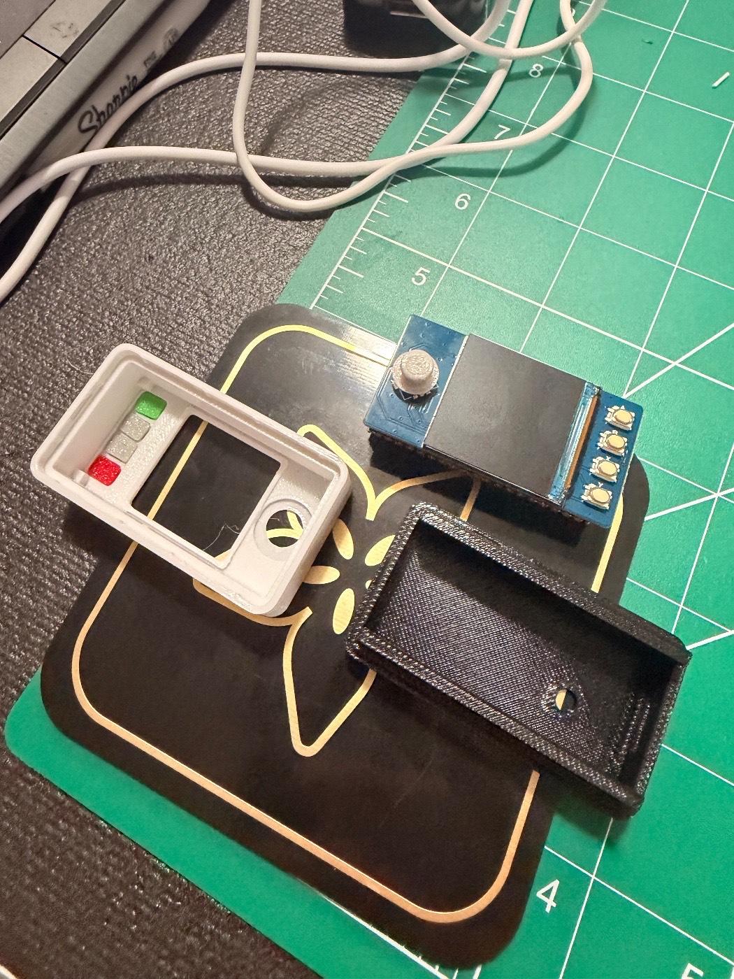
[picture p47: assembly/photos/16-ready.jpg]
Lid, boards and base ready


## 20. Boards into the base

Push the stacked boards, screen up, into the black base. USB-C end first, into the base's hole, then lower the rest. Don't force it straight down. The screen board lies flat on the base's rails. The USB port is centered in the hole, so a cable plugs in cleanly.

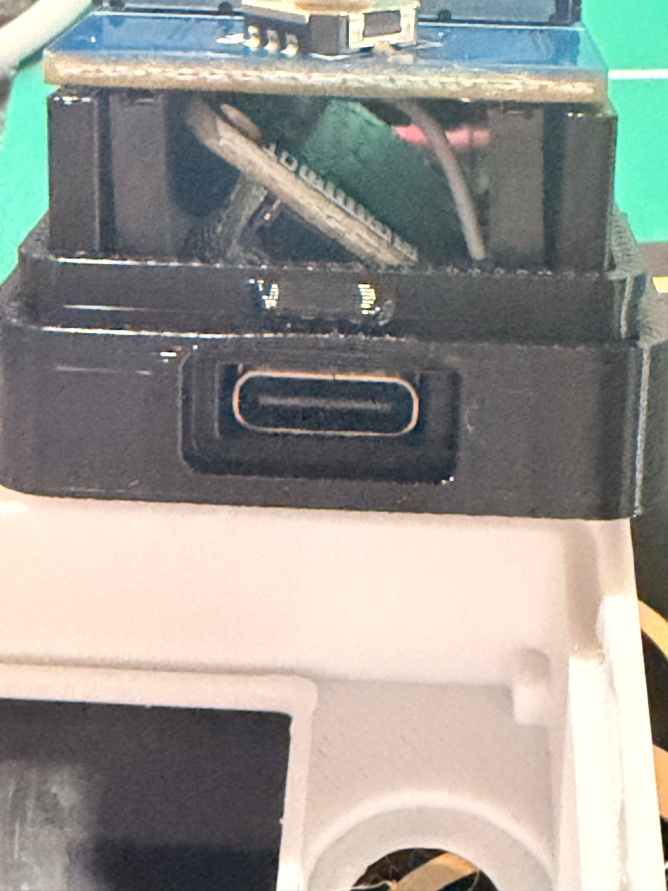
[picture p48: assembly/photos/17-usb-centered.jpg]
USB centered in the hole

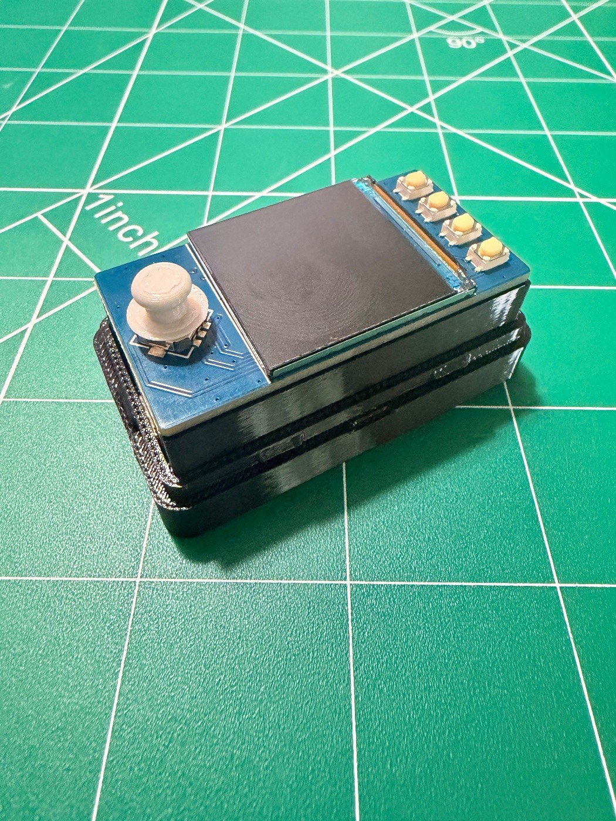
[picture p49: assembly/photos/17-in-base.jpg]
Boards in the base

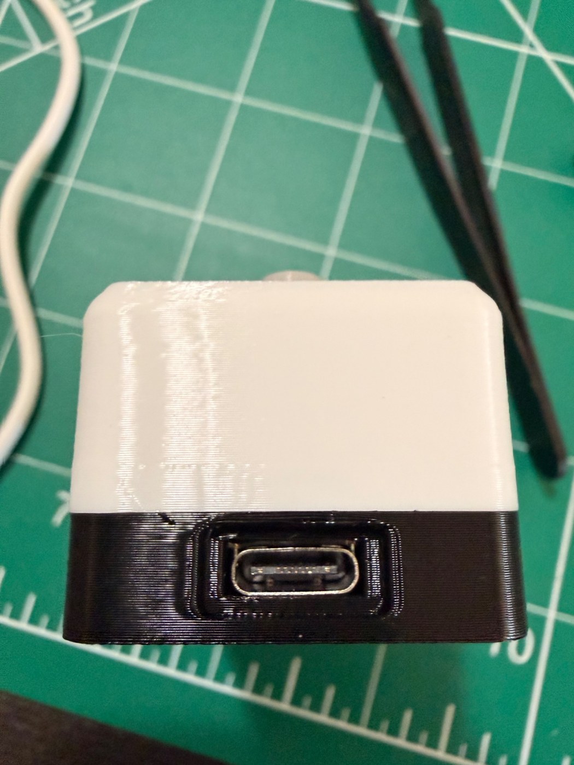
[picture p50: assembly/photos/17-usb-centered-closed.jpg]
USB centered in the hole, case closed


The USB-C port must sit right in the middle of the hole. If it doesn't, something is wrong: take it out and do it again before you close the case.

## 21. Close the case

Flip the base over and lower it, screen side down, into the lid (still face down with the buttons in). Line it up. Keep it upside down and press lid and base together, hard, until they snap. It's tight on purpose, so it won't fall apart.

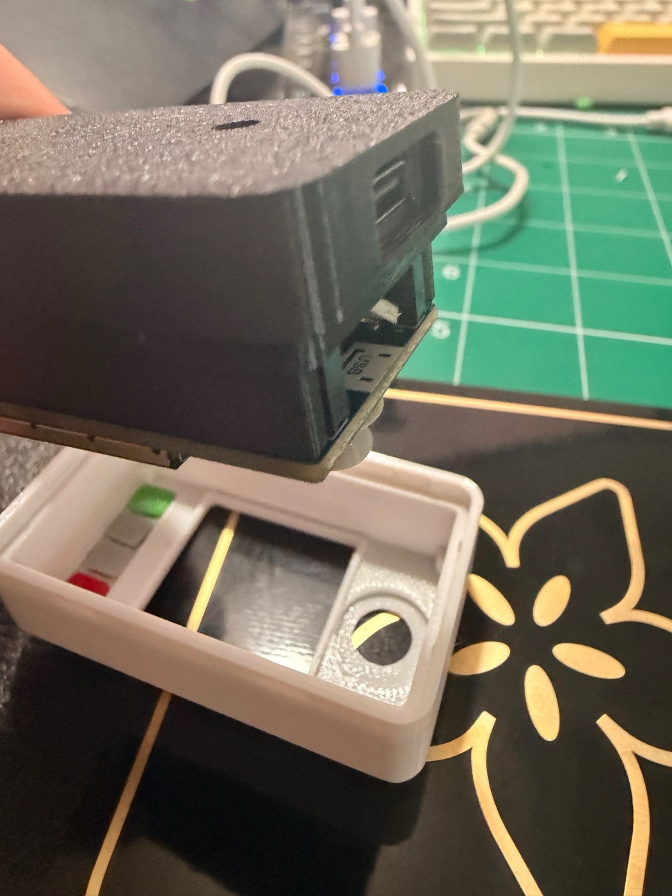
[picture p51: assembly/photos/18-lower-into-lid.jpg]
Lowering into the lid

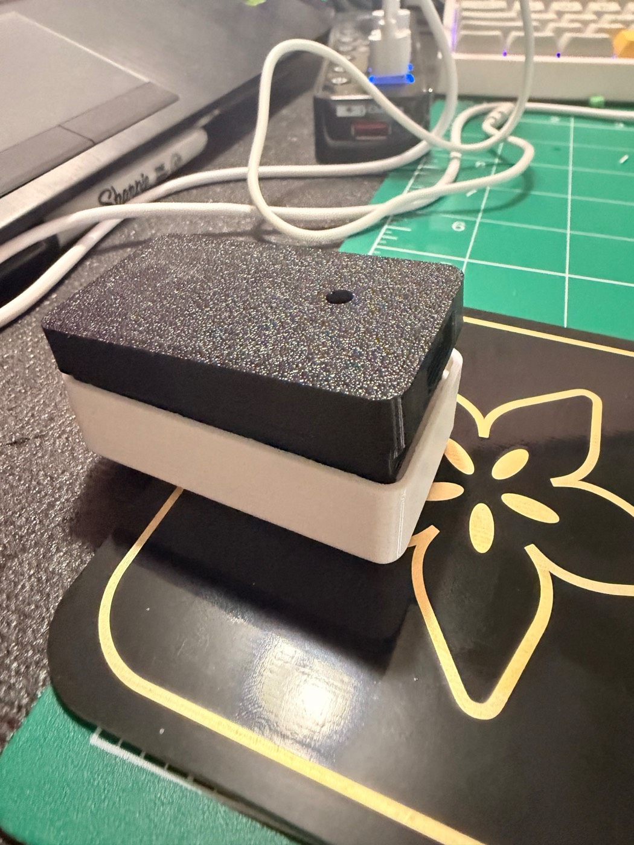
[picture p52: assembly/photos/18-press-closed.jpg]
Pressed closed

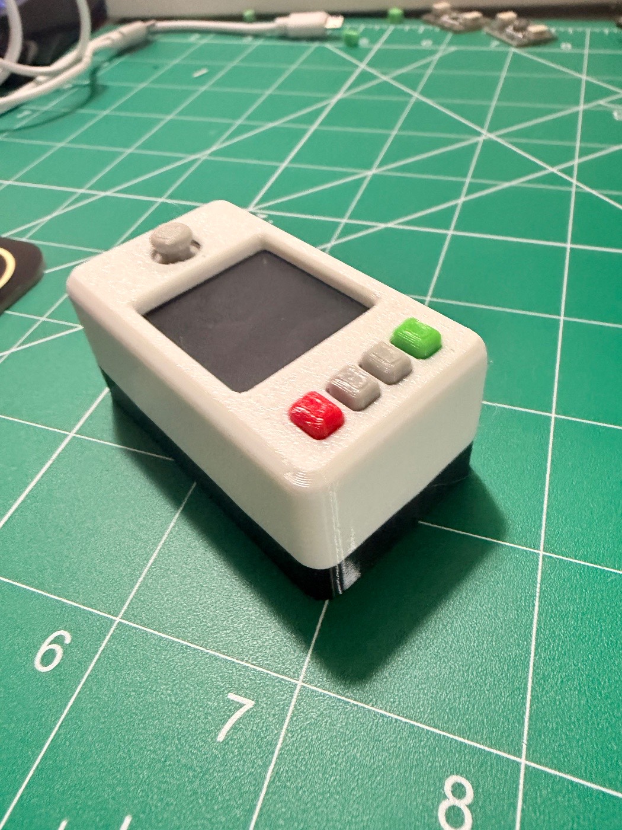
[picture p53: assembly/photos/18-closed.jpg]
Closed

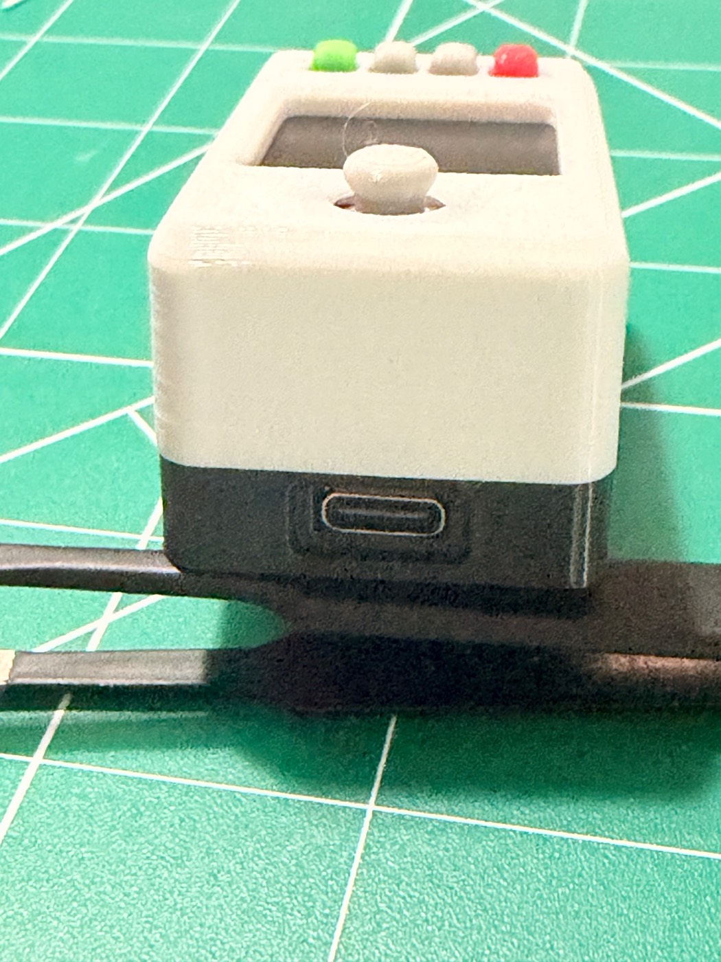
[picture p54: assembly/photos/18-closed-usb.jpg]
USB port, closed


## 22. Check the feel

Press every button. Push the joystick every way and straight in. Each one should click. Look for anything off: a tilted joystick, a stuck button.

## 23. Full test

Plug it in. It shows "No software". Go to wedgie.dev/test and click Test only (skips the wipe and firmware).

The wedgie shows a red FULL CONTROL warning. Press green on the wedgie to let the computer in.

- Chip: wait for the green check.
- Shake: shake, tap, squeeze, lightly drop it on each side until the counter stops. It hammers the chip and the Pico to catch loose wires.
- Buttons: press each one it asks for. The joystick must not hit the wrong button.
- Colors: each press shows a color. Check for scratches, dead pixels, or a line of printer plastic. Clean it off.

PASS on the wedgie and the page: done. Unplug it.

Need to wipe it again after the case is closed? Press BOOTSEL through the small hole in the base with a paperclip while you plug it in.

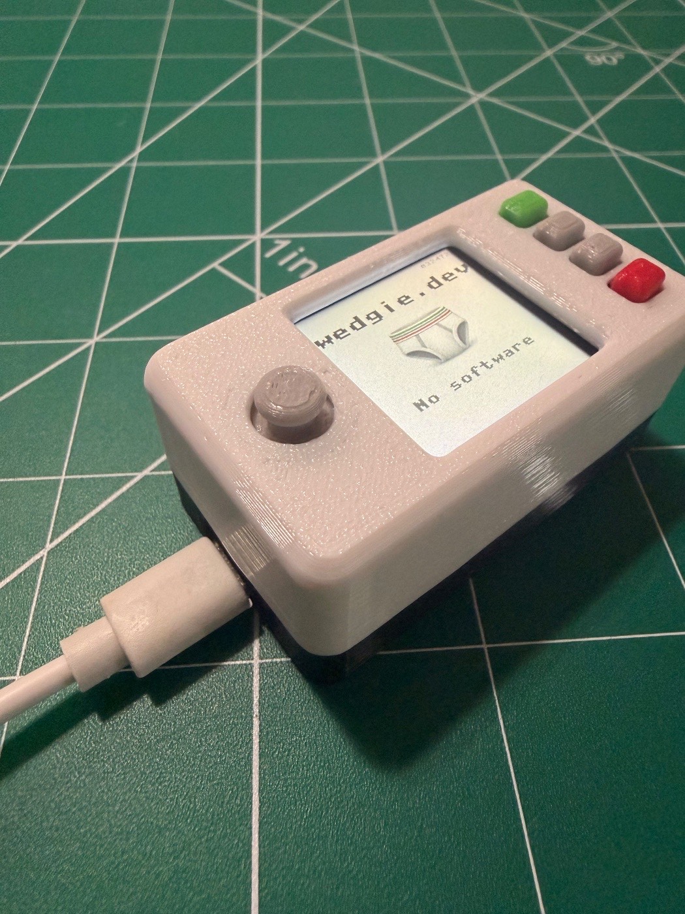
[picture p55: assembly/photos/20-booted.jpg]

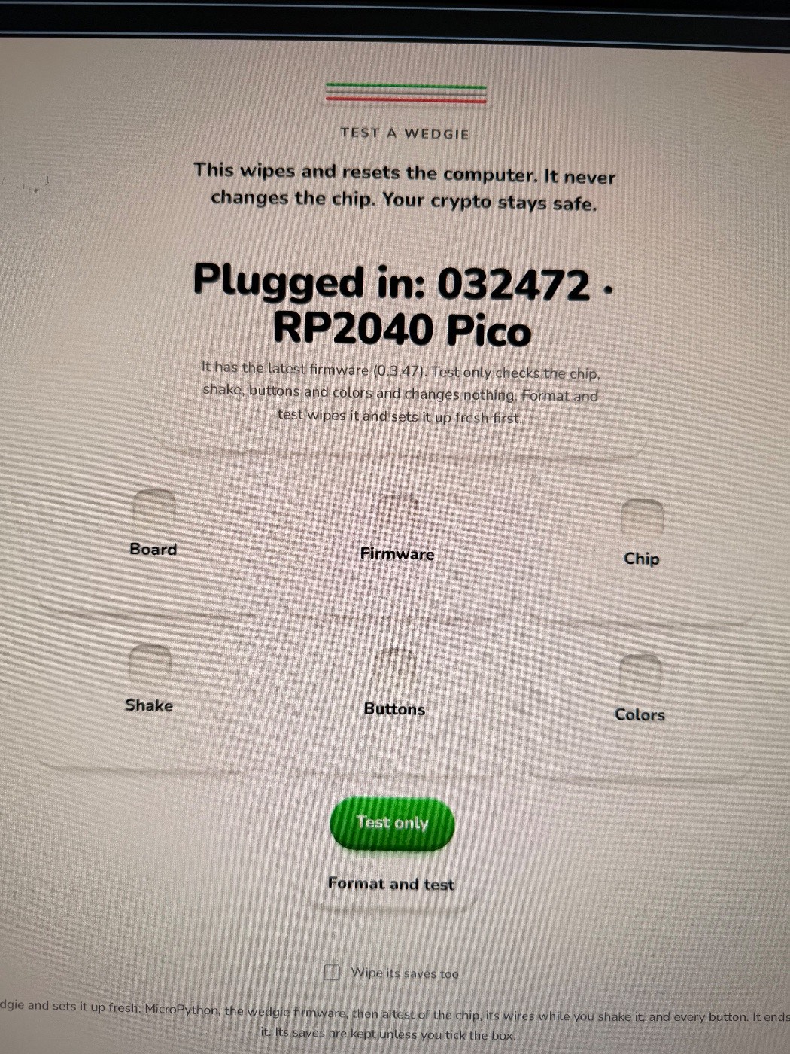
[picture p56: assembly/photos/20-test-only.jpg]
Test only

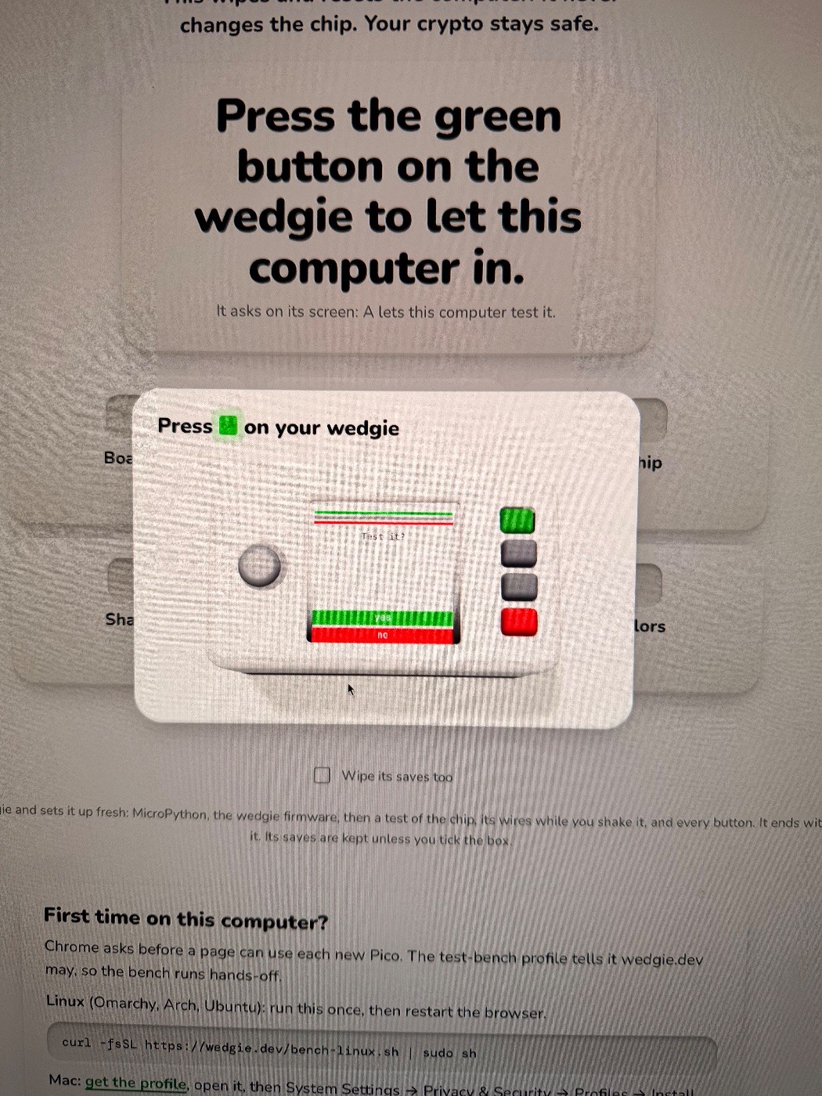
[picture p57: assembly/photos/20-press-green.jpg]
Press green

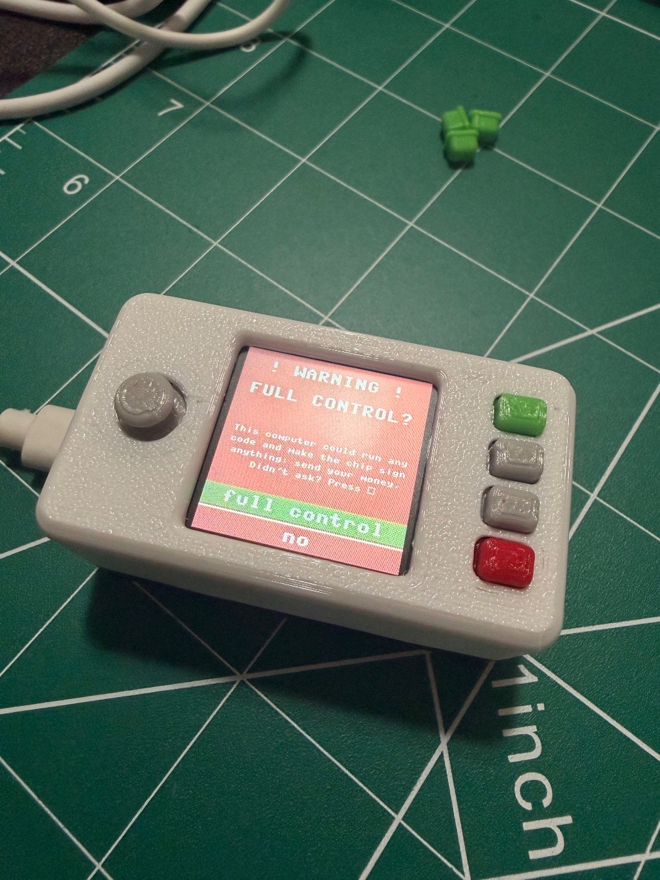
[picture p58: assembly/photos/20-full-control.jpg]
Full control warning

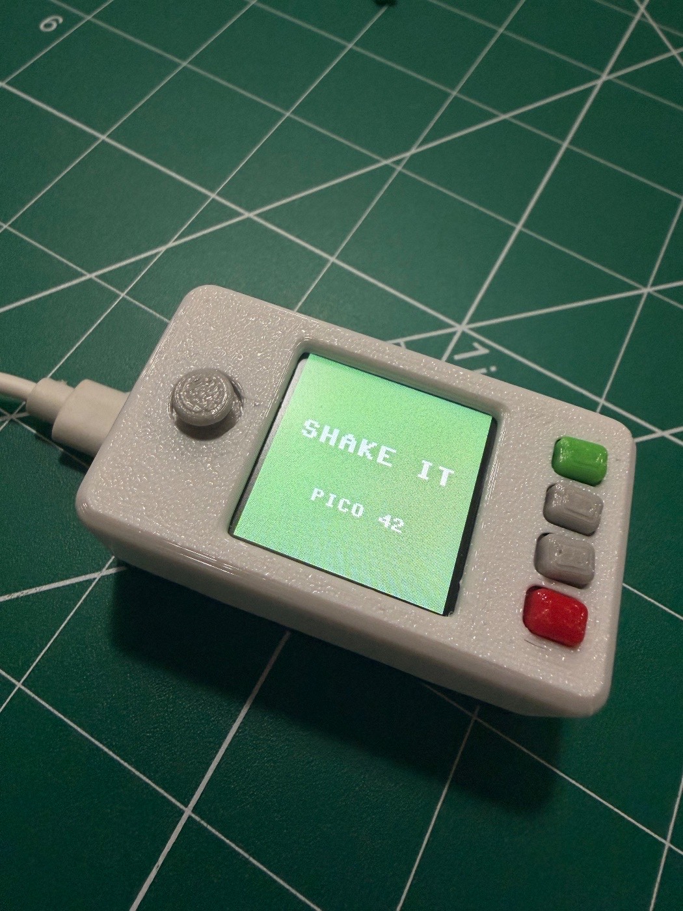
[picture p59: assembly/photos/20-shake.jpg]
Shake it

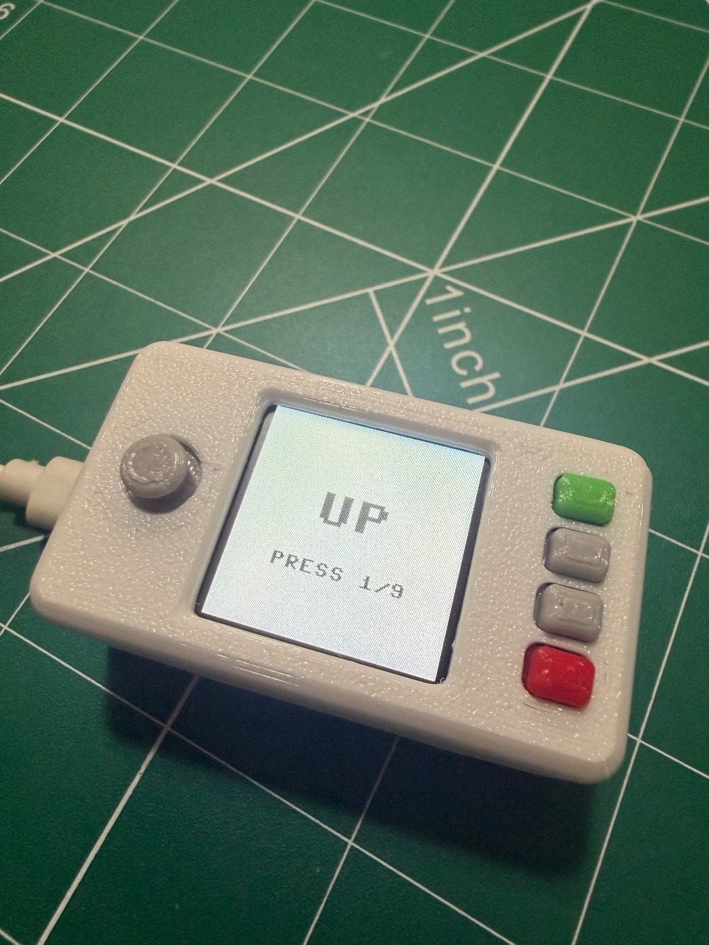
[picture p60: assembly/photos/20-buttons.jpg]
Button test

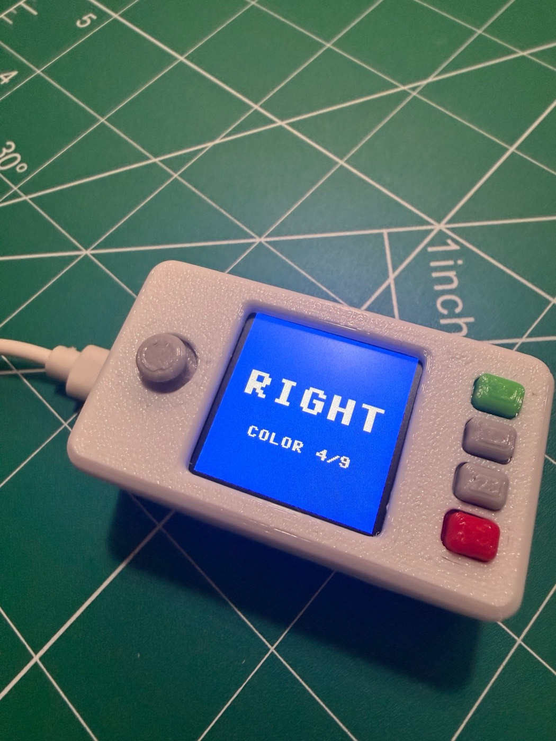
[picture p61: assembly/photos/20-colors.jpg]
Color test

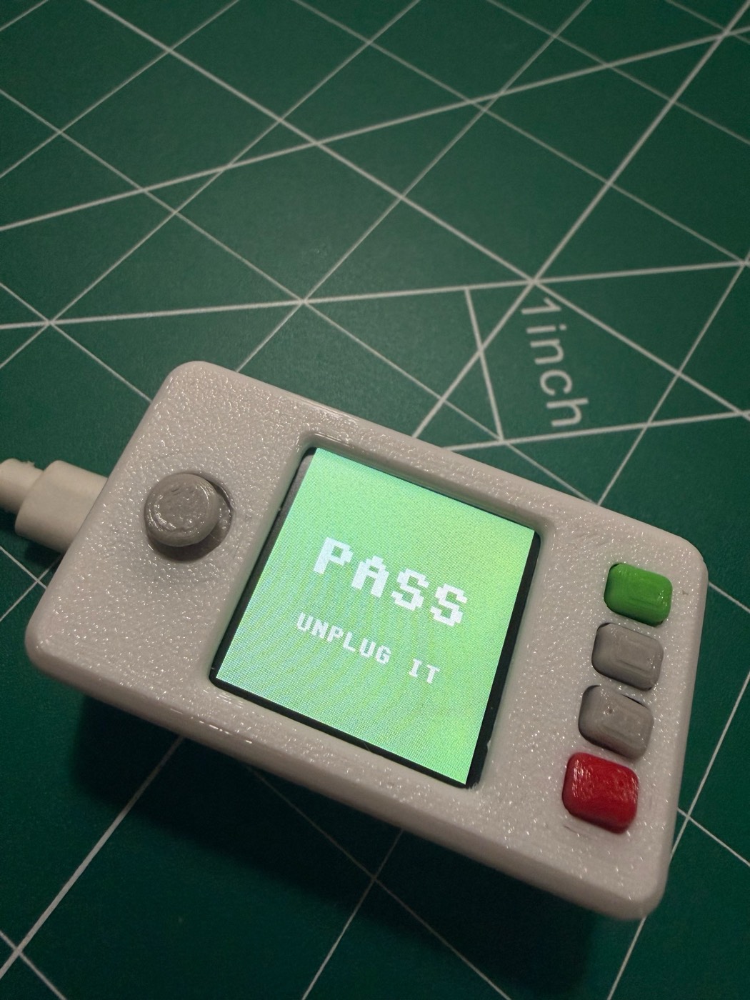
[picture p62: assembly/photos/20-pass.jpg]
PASS on the wedgie

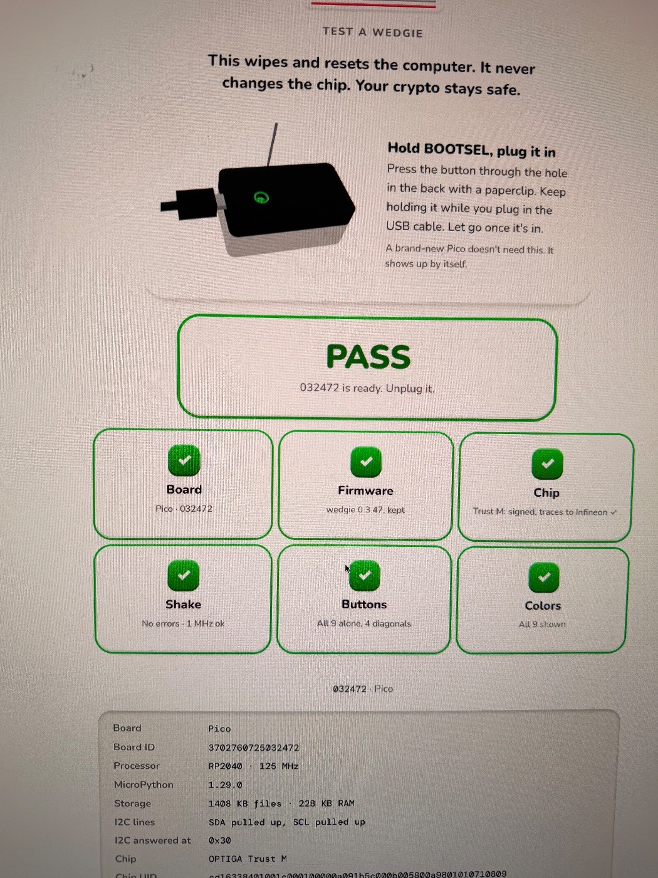
[picture p63: assembly/photos/20-pass-page.jpg]
PASS on the page

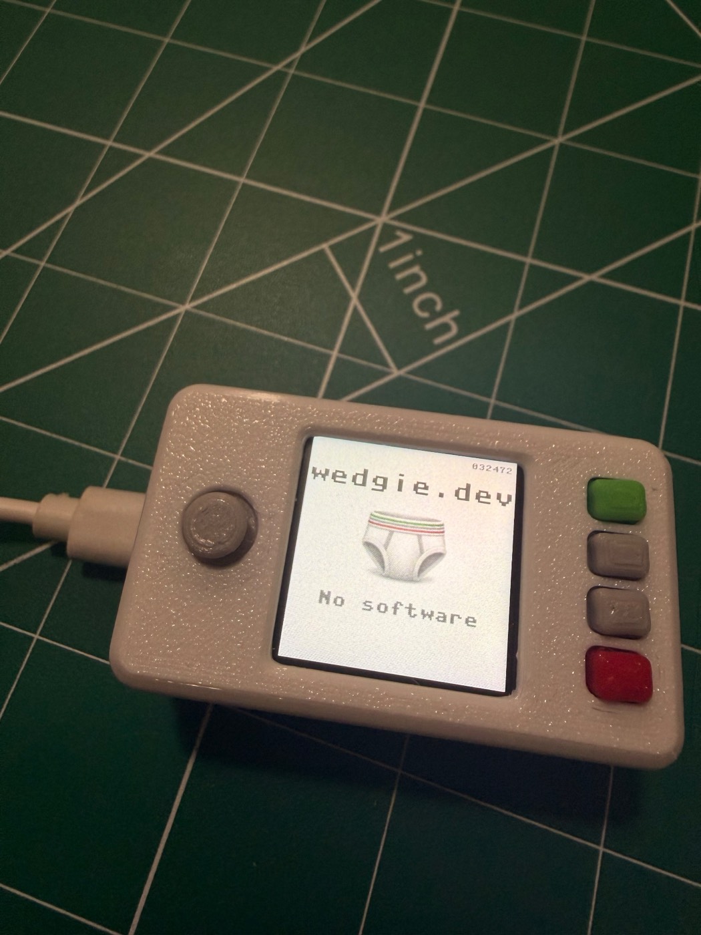
[picture p64: assembly/photos/20-no-software.jpg]
No software


## 24. Box it

Put it in the box. Build the next one. To use it: wedgie.dev/connect.

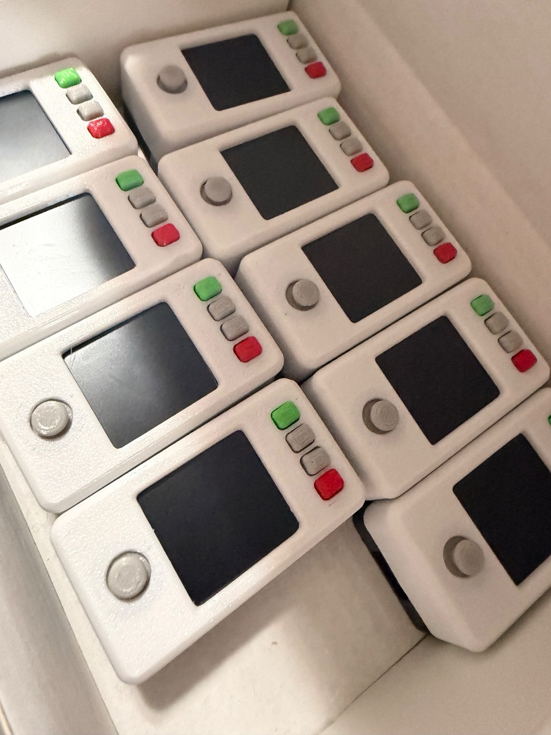
[picture p65: assembly/photos/21-box.jpg]
In the box
