MidnightOnMars/clawd-pico-case/(commit log)

2026-10-13 Docs: 'buttons' means the front caps; RESET button is Atomic Wedgie only
2026-10-13 Rename RESET button STL to aw-reset-plunger.stl so 'buttons' never matches it
    [aw-reset-plunger.stl]
2026-10-13 Docs: mark old AW/battery folders don't-print, fix stale README build/latest notes
2026-10-13 Docs: say how to hold the case for top/bottom button colours
2026-10-14 Assembly: steps 1-2 photos (cable, Trust M plug)
2026-10-14 Assembly: step 3 photos (cut and strip cable)
2026-10-14 Assembly: step 4 photo and wire-to-pin table
2026-10-14 Assembly: step 5 (white and yellow into header); wires push in, no solder
2026-10-14 Assembly: steps 6-7 (tape over wires, poke holes open)
2026-10-14 Assembly: steps 8-9 (black and red, header ready)
2026-10-14 Assembly: steps 10-21 (stack, board test, base, joystick, buttons, close, full test, box)
2026-10-14 Assembly: smooth steps 1-21 (parts list, cut lengths, stacking order, Trust M plug-in, FULL CONTROL screen)
2026-10-14 Assembly: Pico facing, data cable + Chrome setup, chip-fail check, USB end first, paperclip BOOTSEL
2026-10-14 Assembly step 11: always hold BOOTSEL (many Picos ship with software on them)
2026-10-14 Assembly step 11: pink Picos come with software installed (flashing green light), BOOTSEL needed
2026-10-14 Assembly: confirmed cut/strip lengths, green over A and red over Y, green on FULL CONTROL
2026-10-14 Assembly step 3: strip as deep as the header socket, about 1/4 in (6 mm)
2026-10-14 Assembly step 3: strip about 5 mm (between 1/8 and 1/4 in)
2026-10-15 Assembly: new step 10, plug in the chip (photo to come); renumber 10-21 to 11-22
2026-10-15 Assembly: Amazon link for the cables
2026-10-15 Assembly: label the 4 wires in step 2, rotate steps 4 and 13 photos, tape holes photo in step 7, spell out step 10 (plug in and tuck the chip)
2026-10-15 Assembly: step 2 photo cropped to wires, plug and chip, gap between black and red closed; rename rotated photos so caches reload
2026-10-15 Assembly step 10: show the plug-in photo until a real one is taken
2026-10-15 Assembly step 10: drawing of the chip plugged in and tucked
2026-10-15 Assembly step 10: drawing is the step 9 board with the chip plugged into the plug
2026-10-15 Assembly step 10: AI drawing (gpt-image-2.5-flare) of the chip plugged in
2026-10-15 Assembly step 10: real photos of the chip plugged in and laid down; step 11 adds Pico going on + stacked photos
2026-10-15 Assembly step 10: drawing made from the laid-down photo
2026-10-15 Assembly: move 'How the plug fits the Trust M' from step 2 to step 9, renumber
2026-10-15 Assembly: new step 11 'Snap off extra board'; USB-C centered check in boards-into-base step
2026-10-15 Assembly step 6: drawing of poking the holes through the tape
2026-10-15 Assembly: step 6 drawing redrawn from the photo; new step 15 'Check the USB-C fit'
2026-10-23 resin-v1: Formlabs SLA variant (J24-B full-flange joystick, eased snap)
    Fork of clawdbatg/clawd-pico-case @ b7024a88 for Formlabs resin printers.
    Changes: joystick flange 0.24->0.40 mm (J24-B), catch hook 0.5->0.45 mm and
    closing ramp 28->18.8 deg (v1_7_lock.py). CAD-validated, not physically
    tested. See FORK-NOTES.md and RESIN-PRINT.md.
    [base.stl, button.stl, full-set.stl, joystick.stl, lid.stl]
2026-10-23 docs: full clear enclosure - base also Alpha Clear (3 prints total)
2026-10-23 docs: fork banner on README, print sheet at stl/resin-v1/README.md (Colour + Resin columns)
    - README.md: banner at top explaining what the fork is, how it differs from
    upstream's tested PETG set, where the resin files are, and what to expect
    - stl/resin-v1/README.md: full resin print sheet (mirrors upstream's
    stl/current/README.md pattern), table now lists Copies, Colour, Resin, Printer
    - FORK-NOTES.md: links updated; root RESIN-PRINT.md removed (moved into
    stl/resin-v1/README.md)
2026-10-23 README: frame the fork as the Formlabs resin edition of Austin's Wedgie case
    Adds the project context up top (Austin's own description, linked to wedgie.dev
    and the primary case repo clawdbatg/clawd-pico-case) before the fork-specific
    notes, so a visitor understands what this case is and where the original lives.
2026-10-24 README: resin part table (Colour + Resin + Printer) in the fork banner
2026-10-24 docs: drop the Tough 2000 fit-test recommendation, print the real materials
2026-10-24 docs: which-files-to-print section, printer-agnostic note, full-set is inclusive (not both)
2026-10-24 docs: review fixes - correct upstream link, fit-test honesty, tolerance quote, printer caveats, byte-identical claim
2026-11-12 resin-v1: first-article print sheet, J24-A cap, on-platform warning
    Final pre-print review of the Formlabs resin set (2026-11-12). Docs and one
    added STL. lid.stl, base.stl, joystick.stl, button.stl and full-set.stl are
    unchanged.
    - Print sheet rewritten as a first-article fit test. The resin set is the
    PETG geometry with two snap constants changed, so the fits tuned on FDM
    (crush ribs, joystick socket, catch free play, LCD pads, USB gap, button
    lips) are untested in resin. Adds a first-run print list, a table of
    functional surfaces, a nine-step first fit with bench fixes, and the
    default Alpha Clear cure.
    - Do not print the joystick caps flange down directly on the build
    platfo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
    [joystick-j24-a.stl]
2026-11-12 resin-v1 docs: account for upstream's 2026-11-10 changes
    Upstream main is at 677b0e7, six commits past the fork point (a PETG
    joystick print sheet and a Wedgie Plus base test). None touches the CAD or
    STLs the resin set uses, and none is merged here. This records the review
    and takes its lessons into the resin docs.
    - FORK-NOTES: new section, Upstream since the fork point. What the six
    commits are, what was taken from them, and what to know before a merge
    (a trial merge was clean; the Wedgie Plus base does not fit a resin lid,
    and this fork's CAD would not rebuild it).
    - Snap: upstream found that PETG cases get easy to open after a while and
    is testing a 0.54 mm hook, wider catches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
2026-11-12 resin-v1 print sheet: operator brief, full and short print lists
    Simpler handoff for the first run.
    - Operator brief at the top of the print sheet: which list to print, the
    one hard rule (joystick caps never flange down on the build platform),
    the Alpha Clear cure, and where the assembler's part begins.
    - What to print now has two lists. The full list (two lids and bases, six
    joystick caps, rigid spare buttons) is the ideal first run. The short
    list is one case, for when time is tight: one lid, one base, both
    joystick caps at 100 %, four rubber buttons. Adds how to choose and the
    order in which to add extras back.
    - Board note: the base was drawn and measured for the pink USB-C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
